mors-es/maison-petales/docs/README.md

# Maison en Pétales

Bienvenue sur le répertoire de la documentation de la Maison en Pétales.

Vous trouverez les notices sous format PDF dans le dossier `notices`.

Les plans se trouvent dans le dossier `plans`.

Enfin le siteweb est hébergé dans le dossier `docs`.
