mors-es/maison-petales/docs/index.md

```
Tous ces documents sont en version “BETA”, toujours en phase de corrections et relectures. Nous comptons sur votre indulgence. Vous pouvez d’ailleurs faire remonter vos remarques/corrections à l’adresse suivante: doc@mors.es

C’est l’occasion de signaler, que ce soit sous forme de “Maison Nomade” ou de “Maison en Pétales”, il existe moins de 4 modèles réalisés. Aucun d'entre eux n’a fait l'objet d’une étude de structure, mais aujourd’hui tous ces modèles sont encore debout après plus de 10 ans pour le premier modèle et plus de 6 montages/démontages. La structure devrait pouvoir tenir une large gamme de conditions, mais à défaut d’une étude propre au projet, les personnes dernières la conception et la documentation se déchargent de toutes responsabilités sur les différentes mises en œuvre.

Nous sommes d’ailleurs à la recherche d’étudiants, d’un bureau ou d’ingénieurs indépendants prêts à nous aider dans la réalisation d’une étude de structure.
```

**Recevez les dernières mise à jour de la documentation**

<div id="mc_embed_shell">
<div id="mc_embed_signup">
    <form action="https://maisonpetales.us10.list-manage.com/subscribe/post?id=a24535dec3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" method="post" id="mc-embedded-subscribe-form" name="mc-embedded-subscribe-form" class="validate" target="_self" novalidate="">
        <div id="mc_embed_signup_scroll">
        <div class="mc-field-group"><input placeholder="email" type="email" name="EMAIL" class="required email" id="mce-EMAIL" required="" value=""></div>
        <div hidden=""><input type="hidden" name="tags" value="14261816"></div>
        <div id="mce-responses" class="clear foot">

        </div>
        <div style="position: absolute; left: -5000px;" aria-hidden="true">
        <input type="text" name="b_5c34adf9c85700841f7de761f_a24535dec3" tabindex="-1" value="">
    </div>
        <div class="optionalParent">
            <div class="clear foot">
                <input type="submit" name="subscribe" id="mc-embedded-subscribe" class="button" value="S'inscrire">
            </div>
        </div>
    </div>
</form>
</div>
</div>

*En cliquant sur "S'inscrire" vous vous inscrivez à la liste de diffusion à propos de la documentation de la Maison en Pétales (maximum 6 e-mails/an)*

## Sommaire

La documentation de la Maison en Pétales se compose de **15 notices sous format A5**. A commencer par une notice d'**introduction**.

* 0 - La Maison en Pétales (*A venir*)

On a ensuite les notices **PIÈCES** qui parlent de la réalisation des différentes “pièces” à assembler de la Maison en Pétales.

* [A - Plancher](https://github.com/mors-es/maison-petales/blob/main/notices/a_plancher.pdf?raw=true) ([format à imprimer](https://github.com/mors-es/maison-petales/blob/main/notices/a_plancher_print.pdf?raw=true))
* [B - Piliers](https://github.com/mors-es/maison-petales/blob/main/notices/b_piliers.pdf?raw=true)  ([format à imprimer](https://github.com/mors-es/maison-petales/blob/main/notices/b_piliers_print.pdf?raw=true))
* [C - Cadres](https://github.com/mors-es/maison-petales/blob/main/notices/c_cadres.pdf?raw=true)  ([format à imprimer](https://github.com/mors-es/maison-petales/blob/main/notices/c_cadres_print.pdf?raw=true))
* [D - Toiture](https://github.com/mors-es/maison-petales/blob/main/notices/d_toiture.pdf?raw=true)  ([format à imprimer](https://github.com/mors-es/maison-petales/blob/main/notices/d_toiture_print.pdf?raw=true))
* E - Marbres (*A venir*)

Les notices **ÉDIFICATION** parlent de la construction de la Maison en Pétales à partir des pièces préfabriquées et des consommables (pare-pluie, isolants, etc.).

* [1 - Fondations](https://github.com/mors-es/maison-petales/blob/main/notices/1_fondations.pdf?raw=true) ([format à imprimer](https://github.com/mors-es/maison-petales/blob/main/notices/1_fondations_print.pdf?raw=true))
* [2 - Plancher](https://github.com/mors-es/maison-petales/blob/main/notices/2_plancher.pdf?raw=true) ([format à imprimer](https://github.com/mors-es/maison-petales/blob/main/notices/2_plancher_print.pdf?raw=true))
* [3 - Structure](https://github.com/mors-es/maison-petales/blob/main/notices/3_structure.pdf?raw=true) ([format à imprimer](https://github.com/mors-es/maison-petales/blob/main/notices/3_structure_print.pdf?raw=true))
* [4 - Ossatures et menuiseries](https://github.com/mors-es/maison-petales/blob/main/notices/4_ossatures_menuiseries.pdf?raw=true) ([format à imprimer](https://github.com/mors-es/maison-petales/blob/main/notices/4_ossatures_menuiseries_print.pdf?raw=true))
* [5 - Isolation et étanchéité](https://github.com/mors-es/maison-petales/blob/main/notices/5_isolation_etancheite.pdf?raw=true) ([format à imprimer](https://github.com/mors-es/maison-petales/blob/main/notices/5_isolation_etancheite_print.pdf?raw=true))
* 6 - Couverture (*A venir*)

> Les notices PIÈCES et ÉDIFICATIONS seront sous format Foldy Zine, une partie *livret* avec textes et illustrations pouvant être lue à son aise et une partie intérieure avec des *planches de dessins* (*A venir*) résumant les étapes à suivre à l’atelier ou sur le chantier. Actuellement seule la partie livret A5 est en cours de réalisation.

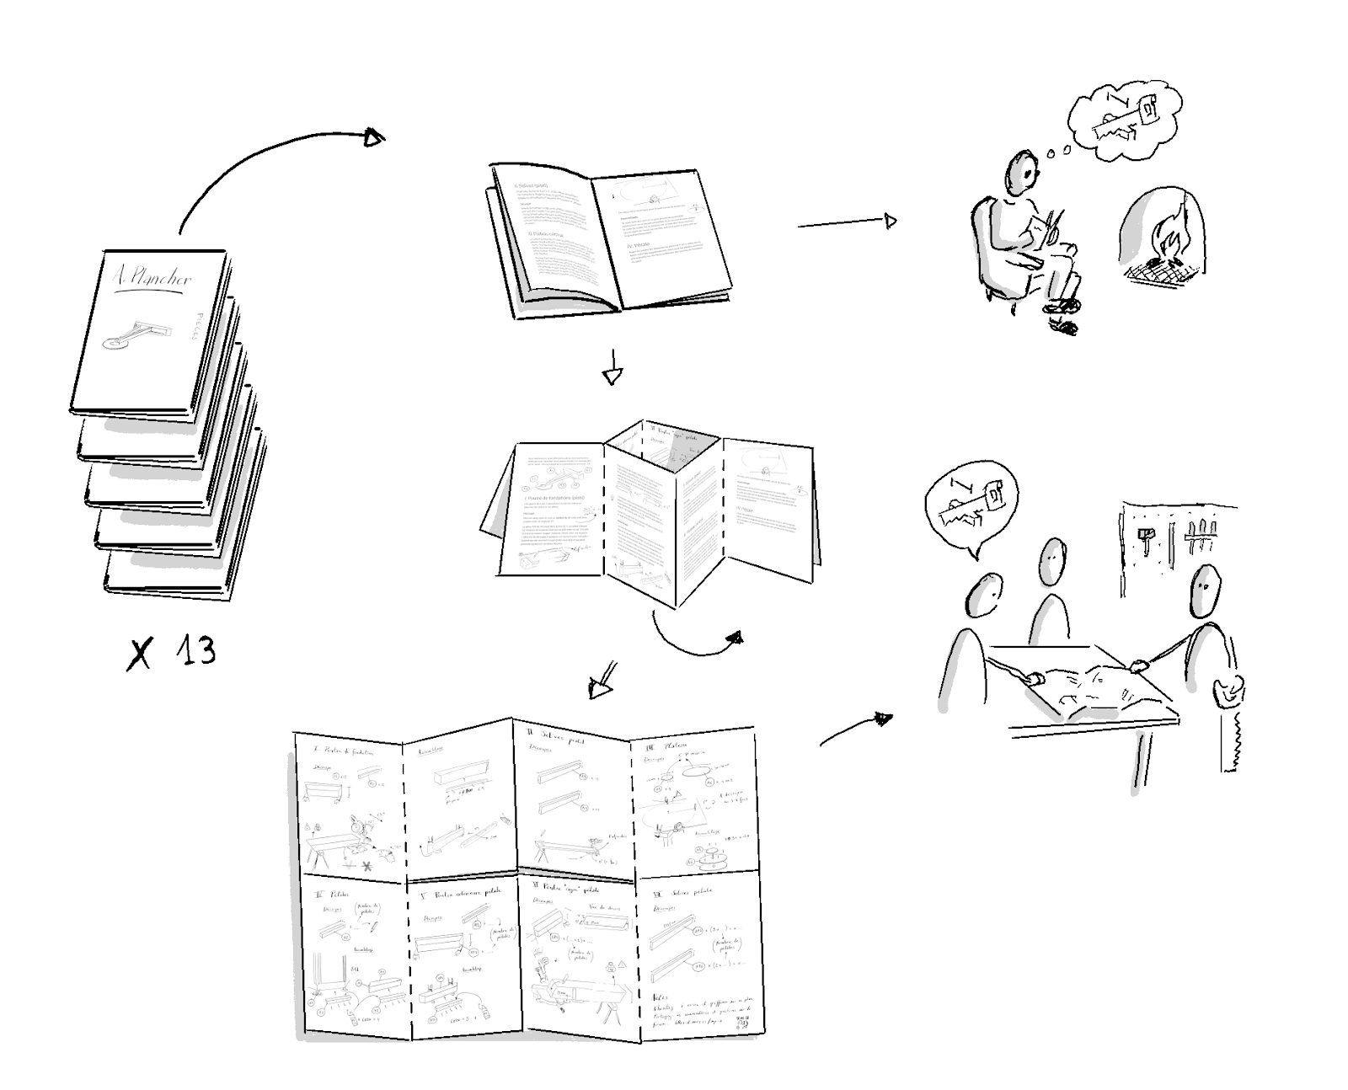
[picture p57: docs/assets/img/foldy_zine.png]


Enfin, les notices **ORGANISATION** sont des livrets plus transversaux permettant d’avoir la vue d’ensemble sur la construction de la Maison en Pétales

* X - Chantier (lieu, outils nécessaires, calendrier, etc.) (*A venir*)
* [Y - Plans & Débits](https://github.com/mors-es/maison-petales/blob/main/notices/y_plans_debits.pdf?raw=true) (plans et vues de coupes de toutes les pièces, listes des débits, consommables). (*Non terminé*, [Tableau des débit](https://docs.google.com/spreadsheets/d/192lDf3B4wyAeSEpOTd4wxV1w-MeTvV6zNtPiaQi830A/edit?usp=sharing), *Non terminé*)

> Cette notice n’en est pas vraiment une car elle prend la forme d’un grand plan en format A0 à afficher dans l’atelier pour y trouver l’ensemble des mesures et débits. Ce plan peut aussi être utilisé pour marquer la progression de ce qui a déjà été fait.

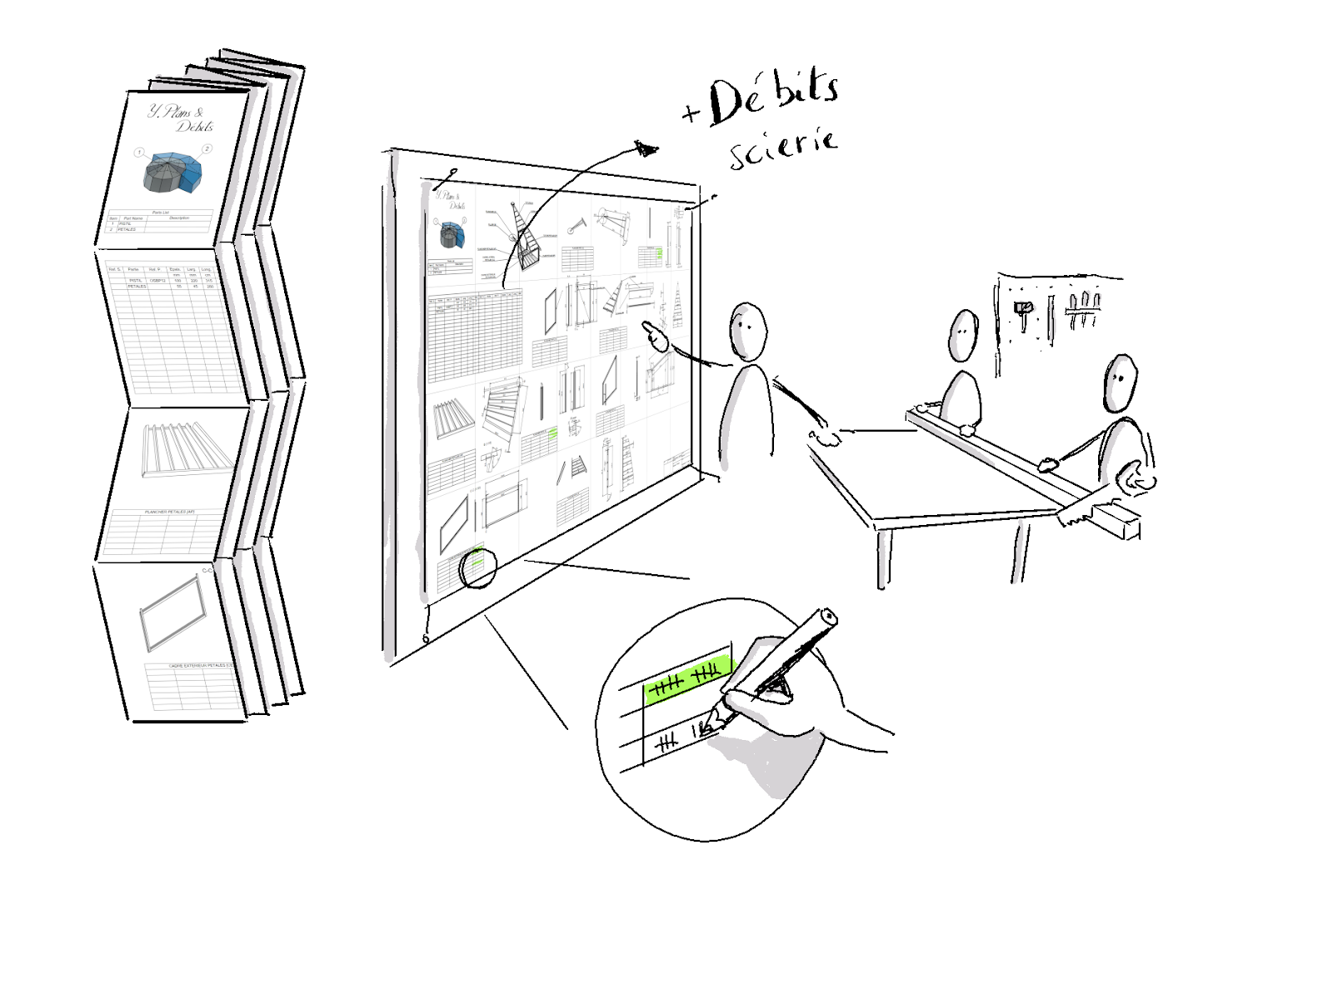
[picture p58: docs/assets/img/plan_atelier.png]


* Z - Conseils, Trucs et Astuces (utilisation des outils, conseils, vocabulaires, FAQ, etc.)  (*A venir*)

## Autres liens

* [Maisons Nomades/Maison en Pétales](https://www.maisonsnomades.net/la-maison-en-p%C3%A9tales): Le siteweb du concepteur de l'habitat, Yves Desarzens. Vous y trouverez la genèse du projet, ainsi que les plans 3D Sketch Up.
* [Le Croissant Fertile](https://lecroissant.desobeissancefertile.com/): Lieu d'expérimentation autour de l'habitat réversible dans le Perigord Vert, là où la premère Maison en Pétales a été réalisée.
* [Et Saar'part](https://www.youtube.com/@EtSaarpart): Chaine du Youtubeur *Saar* qui a tourné 8 vidéos tutorielles sur l'édification de la première Maison en Pétales. 

## Contribuer

Comme vous pouvez le voir cette documentation n'est pas encore terminée. Il existe plusieurs manières d'amener sa pierre à l'édifice.

### Remarques et relecture

Toutes remarques/retours sur la documentation sont les bienvenues, la mise en place d'un forum de discussion est envisagé. En attendant vous pouvez envoyer vos remarques à l'adresse suivante: doc@mors.es

D'ores et déjà un tout grand merci à Aurélie, Benoit, Louise et Yves pour la relecture et vos conseils avisés. Plus largement, merci à tous les participants et participantes du chantier de la Maison en Pétales de septembre 2023 au Croissant Fertile sans qui cette documentation n'aurait été possible.

### Financièrement

Vous pouvez également décider de soutenir le projet en participant financièrement aux frais qu'il occasionne. Sur [Liberapay](https://fr.liberapay.com/Morses/donate) ou [mon PayPal](http://paypal.me/dmorses) (Dorian aka Morses). Il est également possible de [soutenir la dynamique du Croissant Fertile](https://lecroissant.desobeissancefertile.com/nous-soutenir/) ou encore [les projets vidéos de Saar](https://etsaarpart.odoo.com/shop/donesp-soutiens-notre-travail-fais-une-donation-a-et-saar-part-6#attr=).

### Recherche et développement

Le projet vous inspire, vous avez des connaissances dans le domaine de l'éco-construction. Nous aider dans une étude de structure, d'impact ou tous nouveaux développements peuvent permettre à ce chouette projet de grandir.
