mors-es/maison-petales/(list of files, cad)

Other CAD files:
plans/Mn 40m² avancement Août 2023.skp
