mors-es/maison-petales/notices/4_ossatures_menuiseries_print.pdf

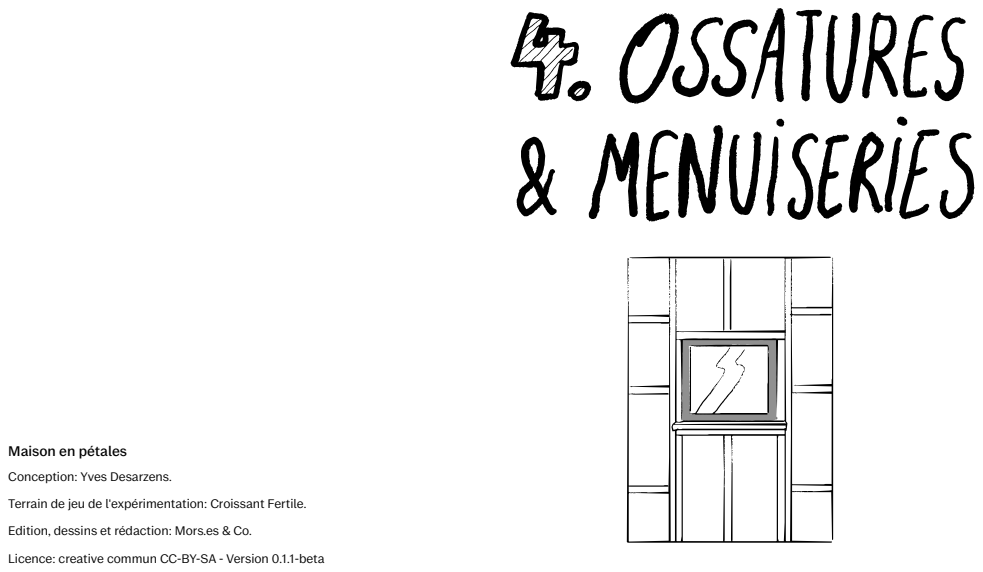
[picture p90: page 1]

Maison en pétales

Conception: Yves Desarzens.

Terrain de jeu de l'expérimentation: Croissant Fertile.

Edition, dessins et rédaction: Mors.es & Co.

Licence: creative commun CC-BY-SA - Version 0.1.1-beta

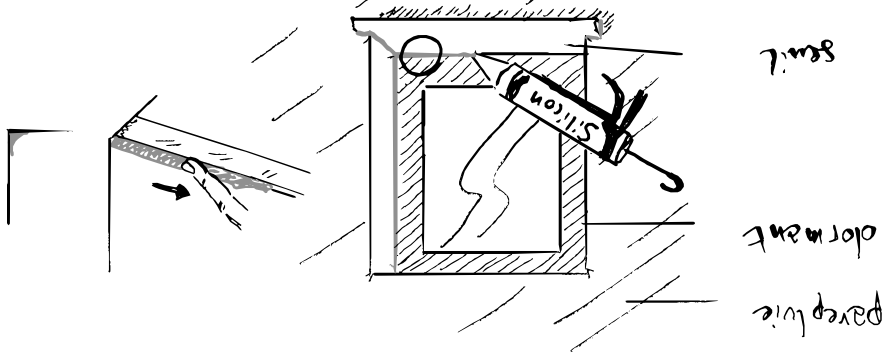
[picture p91: figure]

Etanchéité extérieure

Les menuiseries sont des points sensibles en termes mieux est de d'infiltration d'eau. Pour rendre le tout étanche, le

, parapluie et seuil. Pour dormant poser un joint de silicone entre peinture et de faire un joint propre on peut s'aider de scotch de oncave. son doigt mouillé à l’eau savonneuse pour le rendre c a juste pas de Pour les portes, c'est similaire aux fenêtres, il n'y

traverses basses.

choisis, Il existe plusieurs mises en œuvre selon les éléments r en savoir n’hésitez pas à lire les manuels des fournisseurs pou

plus.

de la Maintenant que nous avons notre structure, il s'agit

) 5 - Isolation & Étanchéité remplir. Cette notice et la suivante ( re sont intrinsèquement liées. On va traiter ça de maniè nes thématique en commençant par l'ossature. Mais certai tâches doivent être attaquées en parallèle.

ne Les cadres par défaut sont composés à l'intérieur d'u héité à l'air couverture en plaques d'OSB (12mm) qui fait l'étanc s cadres et le contreventement des cadres. Mais la surface de tement. Il est bien trop grande pour pouvoir poser l'OSB direc ifier et faut des montants en bois intermédiaires pour rigid permettre de visser les planches d'OSB sur le mur.

de bois de On va travailler ici exclusivement avec des pièces

40x105 mm non rabotées (car non visibles).

56 cm car nos On a fait le choix de mettre les montants tous les arge, il panneaux d’isolant en laine de bois font 57,5 cm de l apter selon suffit alors de les rentrer en force (Écartement à ad e la pose des les dimensions de l’isolant choisi). Dans le cadre d harge des montants d’ossature il faut penser à la reprise de c arbalétriers intermédiaires des pétales

Il existe plusieurs types de menuiseries. Ci-dessus le cas d’une menuiserie ALU. N’hésitez pas à lire la littérature.

On retire d'abord l'ouvrant, ensuite on applique une
compribande dans la réservation prévue à cet effet tout autour de la fenêtre. Elle est alors placée dans l'encadrure. Dans notre cas, la fenêtre vient à ras de la surface du mur. L’OSB n’étant pas encore posé (voir Notice 5), on peut s’aider d’une chute de 12 mm pour positionner la fenêtre.

Enfin de fines cales sont utilisées pour bien positionner la fenêtre. Vérifier l'équerrage en comparant les diagonales qui doivent être égales. Puis elle est fixée définitivement avec 4 à 6 vis de 60 mm selon indication du constructeur. L’ouvrant peut aussi être repositionné pour voir s'il s'ouvre et se ferme toujours correctement.

On va donc couper des montants de la hauteur de l'intérieur des cadres (par exemple XX cm pour les cadres des pistils). Pour les cadres latéraux, il faudra couper le sommet avec un angle de 20°.

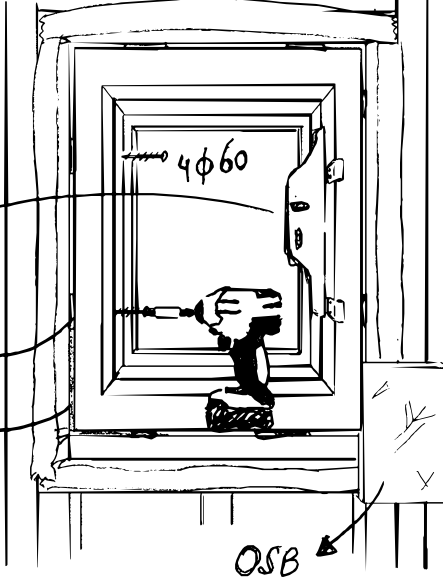
[picture p92: figure]

Il est fort probable que le dernier entraxe n’égale pas la largeur de l’isolant, il faudra donc le découper (voir notice 5 Isolation & Etanchéité). Pour éviter le flambement des montants verticaux il peut être nécessaire d’ajouter des entretoises de 56 cm entre les montants pour rigidifier le tout. De manière similaire il faut les fixer à des hauteurs multiples de l’isolant moins 1 ou 2 cm. Dans notre exemple 120 cm (car isolant de 122 cm de long).

l'aide L'ensemble des montants sont alors cloués ensemble à de d'une cloueuse (3-4 clous de 60 mm par fixation cloués averses manière oblique). Il est important que montants et tr er les soient positionnés à niveau. Il peut être bon de vérifi doubler la mesures également (haut et bas). Il est conseillé de traverse haute pour augmenter sa rigidité.

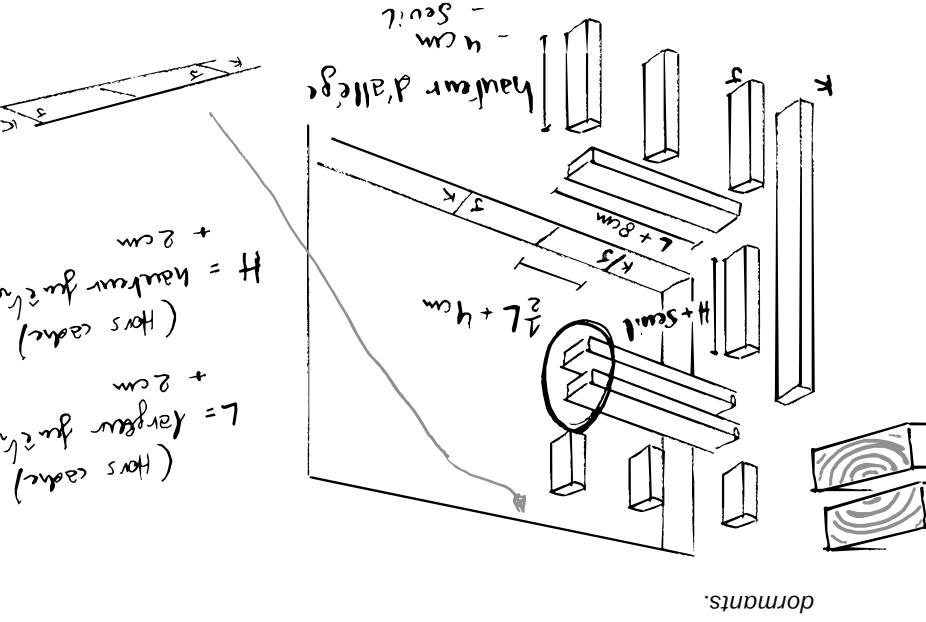
[picture p93: figure]
. dormants

le, il est Lorsque des montants ou traverses sont cloués ensemb r éviter de bon usage de les positionner "coeur à coeur" pou d'éventuelles déformations.

ns des Les seuils des menuiseries peuvent être façonnés da e seuil chutes de bois d'au moins 15 cm de large pour que l une pente de puisse déborder du bardage. Il faut que le seuil aie électrique. 3% ou plus, qui sera réalisée avec un rabot à main ou peut être fait à la scie plongeante. larmier Un are-pluie qui Avant de poser le seuil, il faut venir découper le p rabattre le aura été posé entre temps (voir Notice 5). On vient es montants et pare-pluie vers l'intérieur et le scotcher le long d arapluie où des traverses. Enfin le seuil est posé au-dessus du p r faire du mastic-colle PU sera préalablement appliquée pou

l'étanchéité.

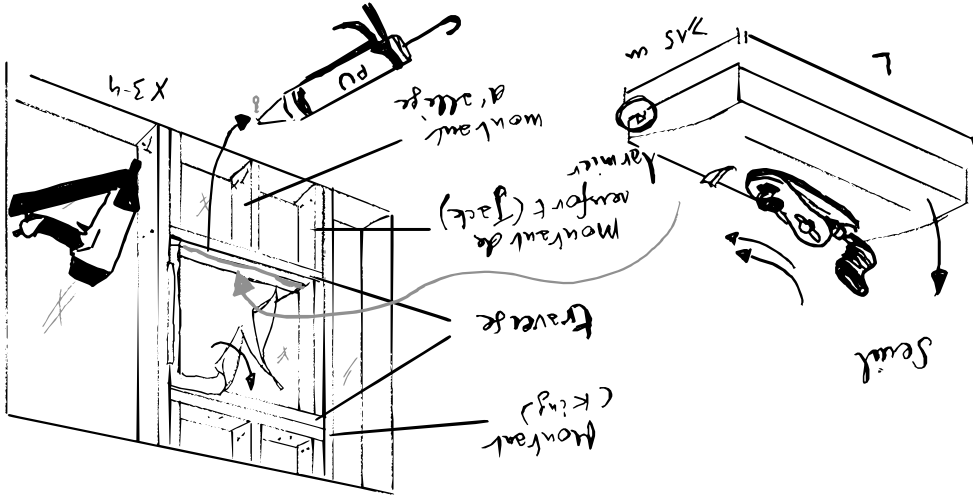
[picture p94: figure]

ique un peu. Si on a une fenêtre ou une porte, alors ça se compl onnes dont Il ne faut pas hésiter à se faire aider par des pers

c'est le métier.

, il y a plusieurs mesures pose en Tunnel Dans le cas d’une hors teur importantes: Les deux premières sont la largeur et hau

). Pour les H et L de la fenêtre plus 1 à 2 cm de marge ( cadre

) et les traverses, Jack ), les montants de renfort ( King montants ( cm (SX) on va utiliser le bois raboté 4 faces en 4 cm par 10,5 ser le non- pour les allèges ou le reste du cadre on peut utili

raboté (SY).

du cadre où On vient marquer le centre de la fenêtre dans le bas à la droite et la elle sera positionnée (pistil ou pétale) et ensuite

+ 4 cm. On vient L gauche de ce centre on marque un demi allège d’ ensuite couper les montants de renfort à la hauteur

On coupe moins 4 cm (traverse) et moins la hauteur du seuil.

es également les traverses et les montants encadrant l
