mors-es/maison-petales/notices/5_isolation_etancheite_print.pdf

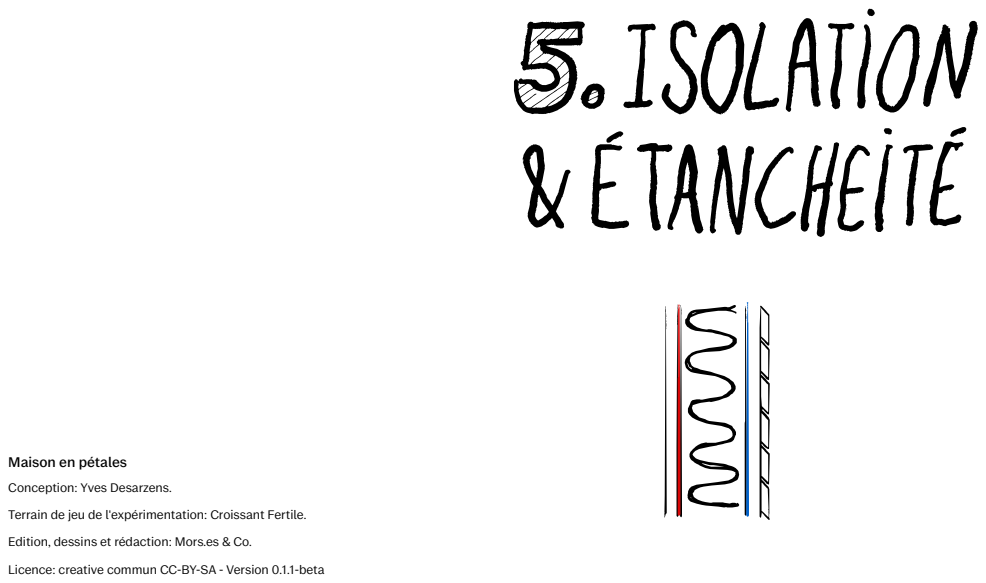
[picture p95: page 1]

Maison en pétales

Conception: Yves Desarzens.

Terrain de jeu de l'expérimentation: Croissant Fertile.

Edition, dessins et rédaction: Mors.es & Co.

Licence: creative commun CC-BY-SA - Version 0.1.1-beta

poser Juste avant de poser les OSB des murs internes, on va e (C4 et des bandes de 30 cm de frein-vapeur d'un bord de cadr deux. On vient C6) au cadre suivant recouvrant le pilier entre les frein-vapeur appliquer une fine bande de colle PU sur le bord du iseries et la pour l'étanchéité ainsi que sur le contour des menu

lisse basse.

SB, quitte à A ras de cette dernière on vient poser le premier O eut être s'aider de petits cales de ~5 mm. Ensuite la chute p

8 par utilisée au-dessus. On utilise des vis de 40 mm, 4 à

planche.

qui supporte la Pour isoler le plancher il faut utiliser un isolant s comprimée compression. Ici nous utiliserons de la laine de boi oser un OSB de 6 cm d'épais et qui s'emboite. Ensuite on vient p reuve d'un de 18 mm en "sur-plancher" flottant. Il faudra faire p angles. peu de patience pour les découpes, notamment dans les

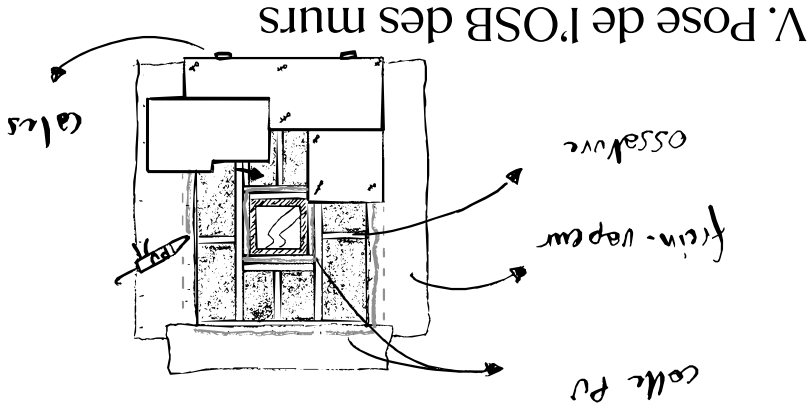
[picture p96: figure]

struction Par rapport à d'autres méthodes constructives, la con olation et en bois demande beaucoup d'attention en termes d'is notamment de gestion des flux d’air. En effet la structure est tériorer sensible à l'humidité qui sur le long terme peut dé l’ossature bois et l’isolant de la maison.

Principe de base

imite les flux Dans la construction ossature bois le frein-vapeur l vitant le d’air et la pénétration d'humidité dans les parois, é rriture de risque de condensation dans les murs et donc de pou aire sortir l’air l’isolant ou de la structure. L’idée de base est de f

(sorties par les contrôlées humide intérieur par des sorties p de fenêtres, bouches d’aération ou VMC). Il existe beaucou

: on veut éviter à tout A retenir littérature pour creuser le sujet.

prix que l'air humide intérieur migre dans la paroi.

une simple Le schéma suivant semble complexe, mais il s'agit d' tance de la coupe verticale au niveau du pistil. On voit l'impor

. La ligne bleue continuité à l'intérieur du frein-vapeur (en rouge) il est perspirant représente le pare-pluie. Ce dernier étant midité des nécessaire de prévoir une lame d'air pour évacuer l'hu

murs.

nc une Le pare-pluie supporte mal les UVs du soleil, on a do n bardage couverture finale (voir Notice 6), ici dans l'exemple u bois sur les murs et de l'EPDM en toiture.

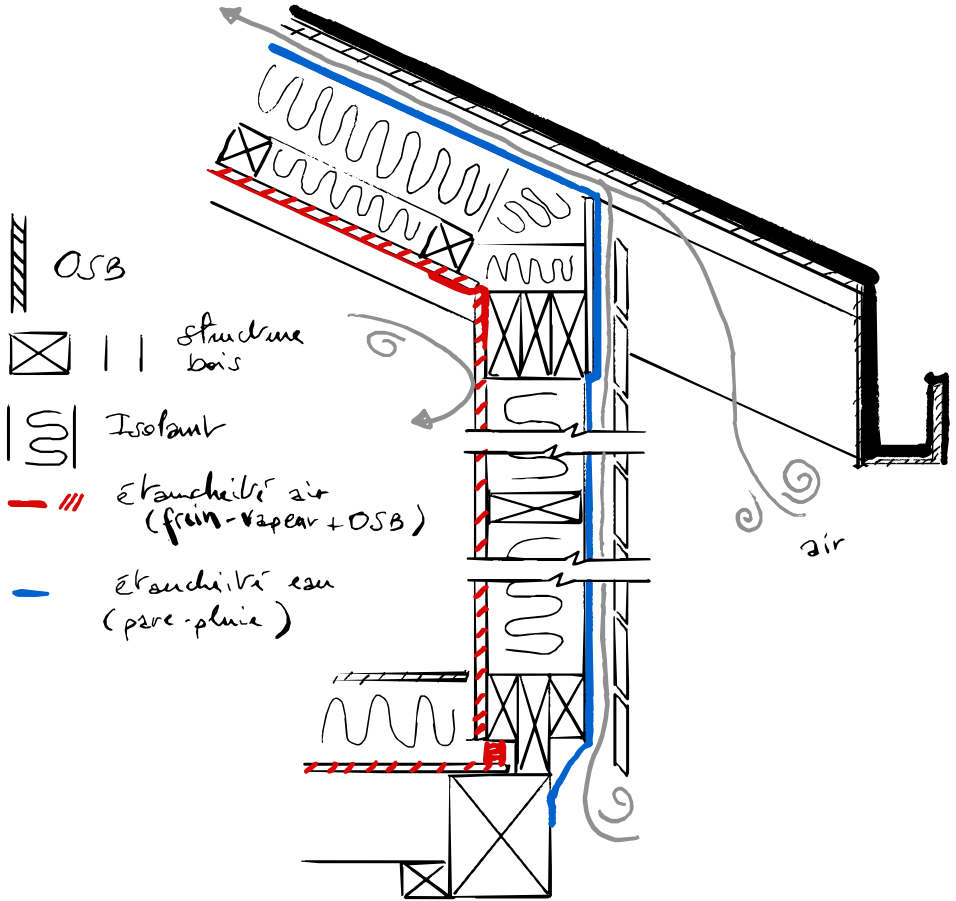
[picture p97: figure]

Le parapluie vient se poser en commençant par le bas en laissant au minimum 30 cm de débord à l’extérieur des cadres. Sur la toiture, il est plié pour passer d'un pan de toit à l’autre. Le niveau suivant vient se poser par-dessus en chevauchant le précédent d'au moins 20 cm. Il faut suivre le chemin que font les gouttes d'eau pour qu'elle ne passe jamais sous un pare pluie. Il est ensuite agrafé sur les arbalétriers. Enfin on scotch les lés avec de l’adhésif pour pare-pluie.

Pour les murs on va "emballer" la structure. en commençant par le bas avec assez de longueur pour fixer le bas du pare-pluie sur les poutres de fondation. On viendra perçer les trous des menuiseries pour venir les y placer ensuite (voir Notice 4).

Lorsque l'ossature des murs est faite (voir Notice 4), on peut venir placer les panneaux d'isolant (10 cm) entre les montants. Attention à bien remplir, notamment les trous et fentes (par exemple entre les cadres et piliers). Pour cela, on peut prendre de l'isolant en vrac et le rentrer en force avec un tournevis ou un ciseau à bois. Une bande d'1mm longue de 10 mètres équivaut à un carré ouvert de 10 cm x 10 cm.

Il est conseillé de s'attaquer d'abord au toit pour mettre la structure à l'abri des intempéries.

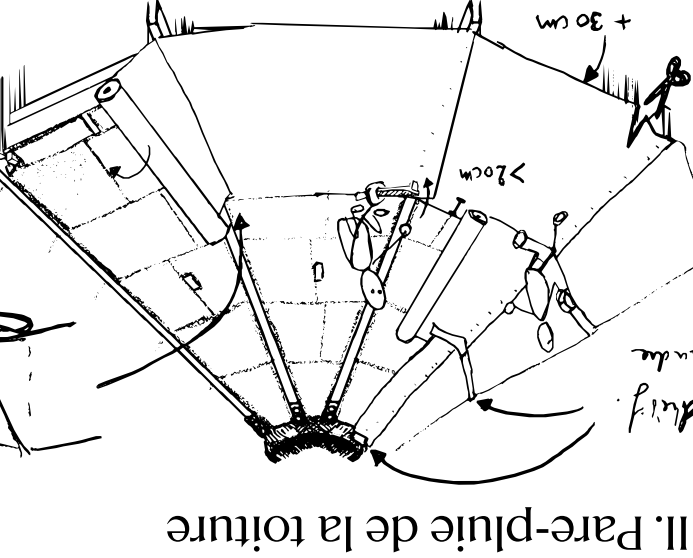
[picture p98: figure]

ère de 6 Ensuite deux couches d'isolant sont posées. Une premi onde de cm d'épaisseur entre les empanons et ensuite une sec à mesure 10 cm par-dessus tout. Les coupes se font au fur et

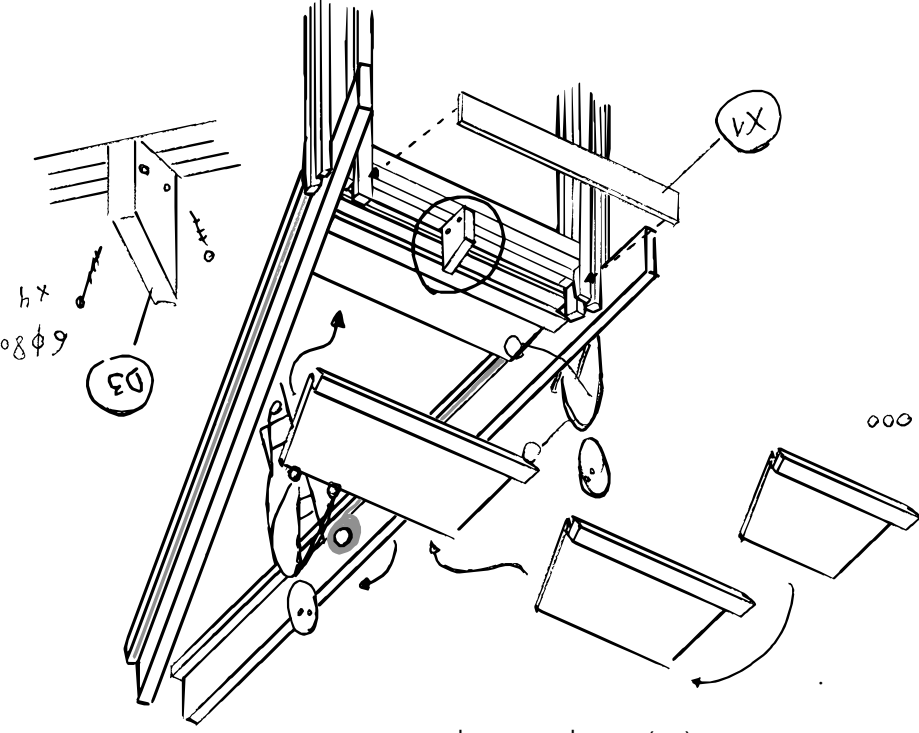
[picture p99: figure]

ond peuvent pour éviter les chutes. Des chutes de l'OSB du plaf ussi fixer la aider à faire la coupe d'angle de l’isolant. Il faut a reprise (D6) sur le 4ème empanon.

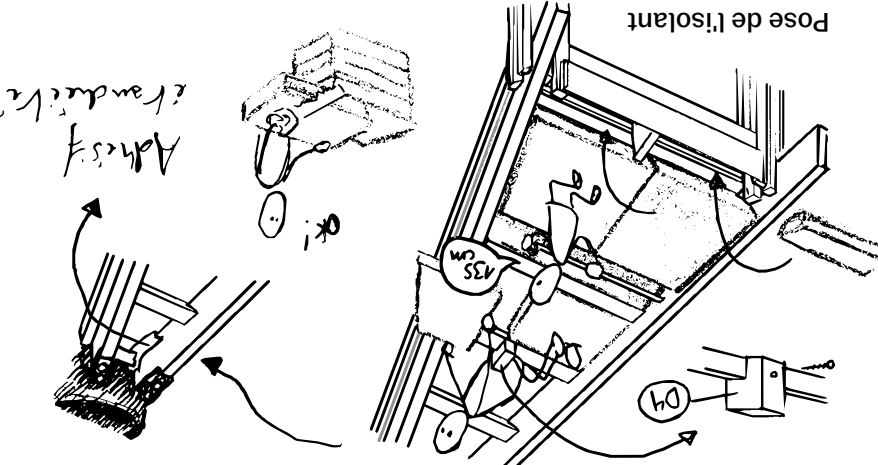
[picture p100: figure]
Pose de l'isolant

Pose de l'OSB servant de plafond

, une série d'OSB ont été coupés et D - toiture Dans la notice nd de la assemblés avec des empanons. Ces OSB seront le plafo l'étanchéité maison en pétales. Ils supportent l'isolation et font

à l'air de la toiture.

Avant d'emboiter les OSB ensemble, on va poser un

DP2 et DP4) compribande sur les fourrures des arbalétriers (D2, pour garantir l'étanchéité à l'air.

En commençant par le bas, les modules du plafond sont fixer, sur encastrés les uns dans les autres. C'est l'occasion de reprise de la les cadres du pistil qui n'auront pas de pétale, la la toiture. contre latte (D3) ainsi que l'OSB qui vient "fermer"
