mors-es/maison-petales/notices/a_plancher_print.pdf

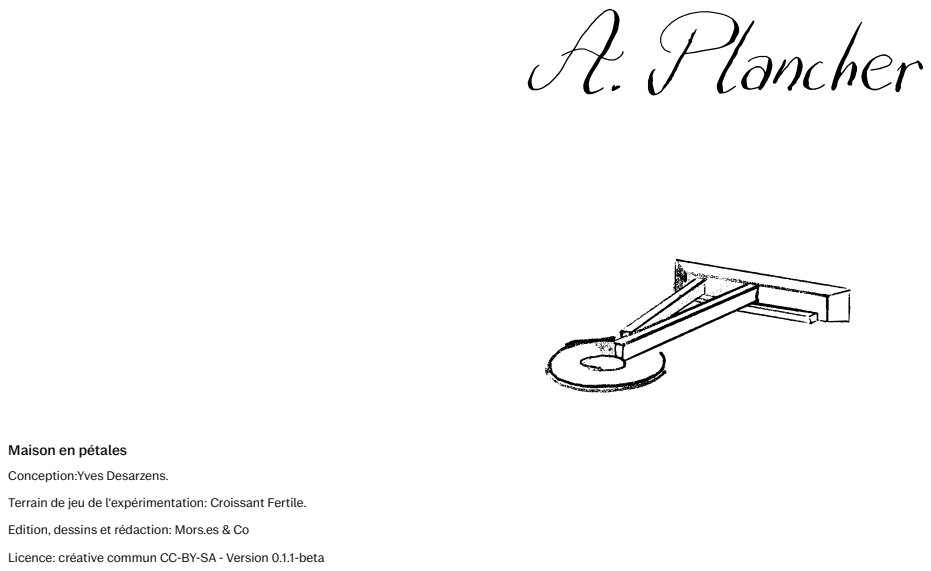
[picture p101: page 1]

Maison en pétales

Conception:Yves Desarzens.

Terrain de jeu de l'expérimentation: Croissant Fertile.

Edition, dessins et rédaction: Mors.es & Co

Licence: créative commun CC-BY-SA - Version 0.1.1-beta

e coupe Rien de sorcier ici, on se retrouve avec 2 longueurs d différentes (299 et 303 cm).

hésiter à écrire (ces notices sont faites pour vivre il ne faut pas qui dans les marges toutes informations complémentaires

semblent utiles)

es nécessaires Est décrite ici la fabrication des différentes pièc es. En pour l'édification du plancher de la Maison en Pétal

. Voici les différentes pièces, voir notice Pistil commençant par le

. Y - Plans et Débits

s Ces poutres de 10 cm par 22 cm reprennent la charge de solives, du plancher, des cadres et des piliers.

Découpes

. Elles sont nombre de 12 Les poutres ont deux côtés et sont au r du donc coupées avec un angle de 15° pour faire le tou plancher qui est inscrit dans un cercle.

end d'abord La pièce (A1) est découpée dans le brut (S-12). On pr rab'. Ensuite les mesures de la pièce pour voir ce qu'il reste en équerre. on trace la mesure "longue" (externe, 193 cm) avec une

"rafraîchir" L'idéal est de découper à quelques cm du bord pour en scierie et qui peut droite la pièce qui est rarement coupée présenter également certaines fissures.

Pour les "pétales" il y a deux types de poutres de fondation. Les rayons qui "prolongent" le pistil et les extérieures. Les poutres dites extérieures (AP1) seront coupées et assemblées de la même manière que les poutres du pistil avec leur solivette (AP2).

Les poutres “rayons” (AP3) sont plus particulières. En effet la forme de ces dernières n'est pas trapézoïdale mais est sous la forme d'un parallélépipède avec une légère coupe de biseau.

Pour la découpe de l'angle, l'idéal est d'avoir accès à une scie à onglet radiale à grand disque (> 300 mm). On règle l'angle d'inclinaison de la lame à 15° et on coupe la poutre en 3-4 passages pour éviter de trop user le moteur. Attention à être bien à plat sur le plateau de la scie et avoir une bonne servante vu le poids de la poutre.

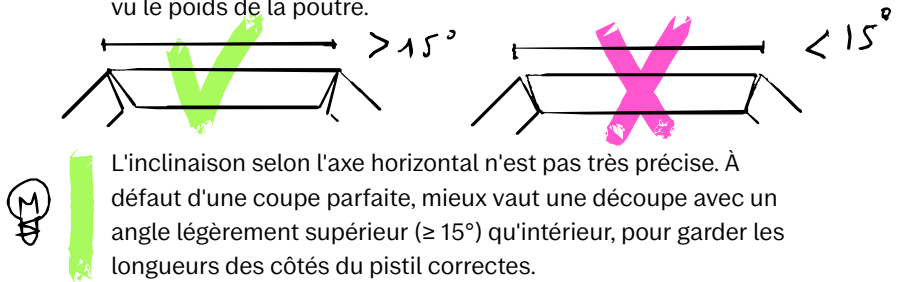
[picture p102: figure]

L'inclinaison selon l'axe horizontal n'est pas très précise. À défaut d'une coupe parfaite, mieux vaut une découpe avec un angle légèrement supérieur (≥ 15°) qu'intérieur, pour garder les longueurs des côtés du pistil correctes.

Ensuite, il faut découper les solivettes (A2) dans le bois (S-11) en angle droit d'une longueur de 160 cm.

Assemblage

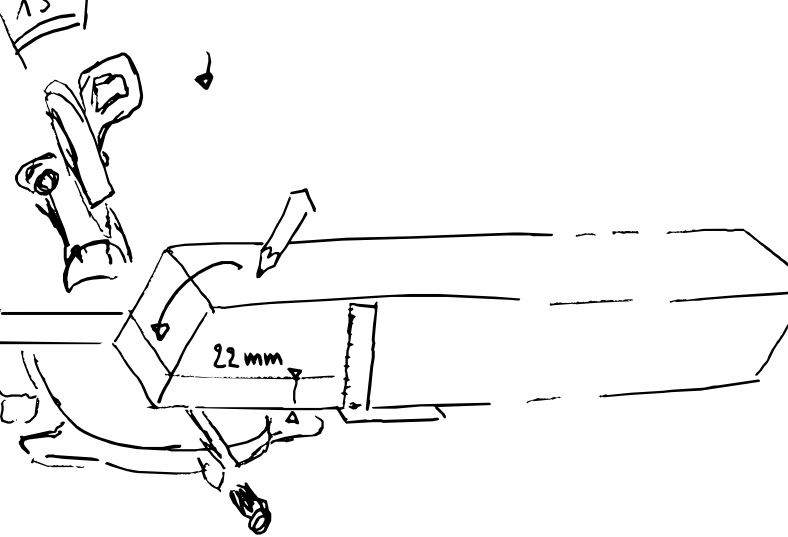
[picture p103: figure]

Les solivettes sont vissées-collées sur les poutres de fondations avec de la colle PU et 4 vis (6⌀100). On pré-perce les 4 trous pour les vis dans la solivette (entre 4-6 mm de diamètre), on vient poser ensuite la colle sur la face de la solivette qui sera collée. Les solivettes sont visées avec une visseuse dans le bas de la face intérieur au pistil de la poutre de fondations. Des cales peuvent aider à placer plus facilement la solivette.

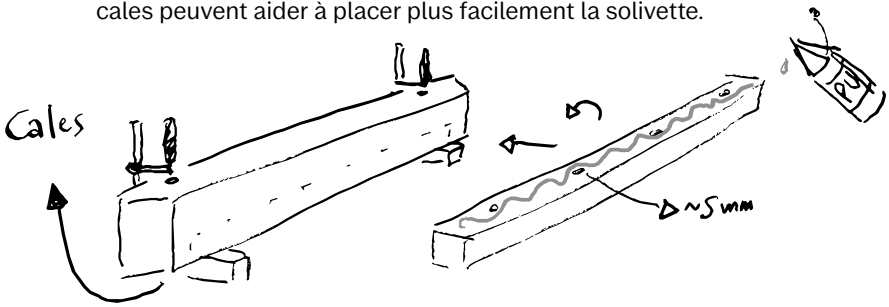
[picture p104: figure]

e butée (A6). On réitérera cette technique pour le petit cercle d

Assemblage

bler Si vous avez deux cercles (A5) vous pouvez les assem ite simplement en les vissant ensemble. Vous pouvez ensu

(A6) bien au centre du plateau (A5) soit cercle de butée visser le les cercles, soit à l'aide des trous centraux qui on servit à tracer t. en traçant le petit cercle sur le grand préalablemen olives des Avant de produire les poutres de fondation et les s res (A2) pétales, il faut découper des solivettes supplémentai les faces pour les pétales. Ces solivettes sont assemblées sur vont accueillir extérieures des poutres de fondation du pistil qui

les pétales.

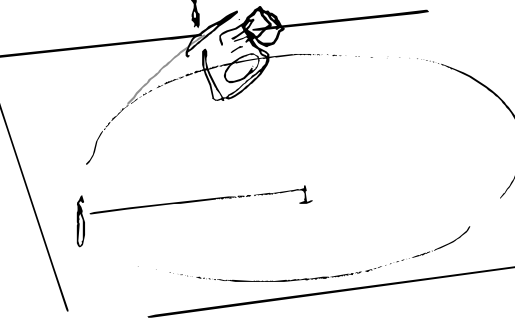
[picture p105: figure]

lives du Coupées dans du bois de 4,5 cm par 16 cm (S-8), les so her, les plancher vont reprendre la charge du poids du planc s. meubles et les êtres vivants de la Maison en Pétale

Découpes

à 90° à faire à Rien de plus simple. Il s'agit ici de simples coupes cm (A3) qui la scie à onglet. Il y a douze solives longues de 333 vingt- seront perpendiculaires aux poutres de fondation et ndront se quatre solives, plus courtes, de 328,5 cm (A4) qui vie voir notice placer proche des angles des poutres de fondation,

. Y Plans & Débits

posées sur un Les solives partant des 12 côtés du pistil vont être

. Ce plateau central rond avec un diamètre de 130 cm (A5)

Son dernier est idéalement en contre-plaqué (CP) marine.

épaisseur sera plus grande que 20 mm. On peut aussi superposer deux CP de 10-15mm par exemple. Les solives

CP de 33,5 longues (A3) viendront en butée contre un cercle en

cm de diamètre (A6).

Découpes

thode la plus Sans être à la recherche d'un cercle parfait, la mé de d'une simple est de tracer un cercle de rayon 65 cm à l'ai teuse, on corde, d'une vis et d'un crayon. Ensuite, à la scie sau ds et suivre vient rejoindre le trait de crayon par l'un des bor udra petit à soigneusement le trait. En fonction de l'établi, il fa

. petit déplacer la planche pour ne pas couper dedans
