mors-es/maison-petales/notices/b_piliers_print.pdf

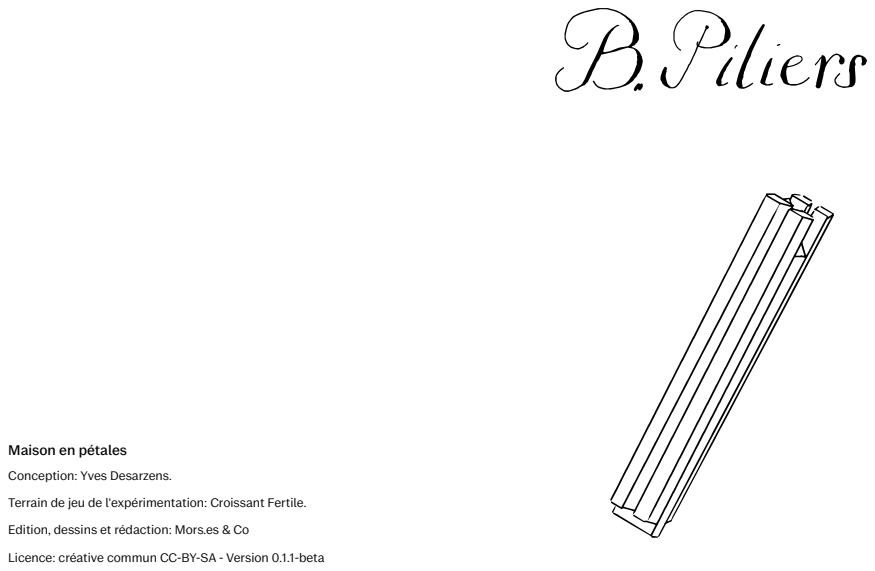
[picture p106: page 1]

Maison en pétales

Conception: Yves Desarzens.

Terrain de jeu de l'expérimentation: Croissant Fertile.

Edition, dessins et rédaction: Mors.es & Co

Licence: créative commun CC-BY-SA - Version 0.1.1-beta

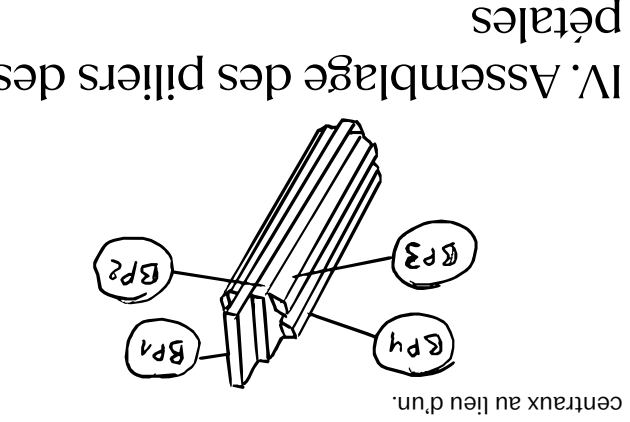
[picture p107: figure]
centraux au lieu d’un.

". Pour La colle PU étant expensive, elle risque de "déborder être éviter d'en mettre partout, la table de montage peut peut recouverte de papier sulfurisé. Et une fois sèche, on enlever l'excédent de colle avec un ciseau à bois.

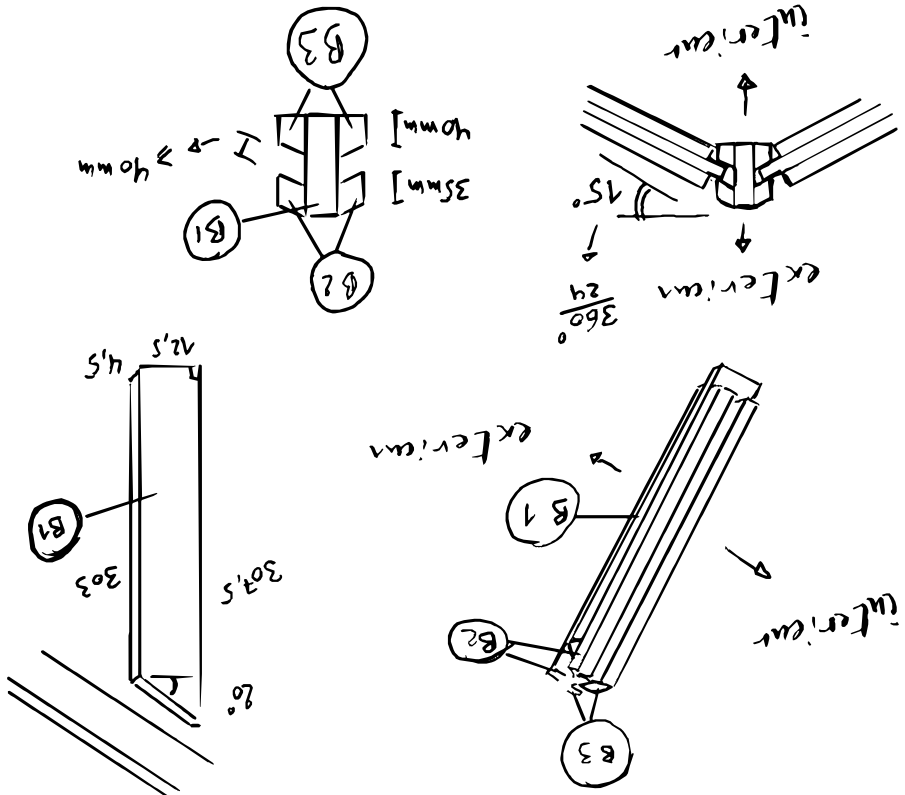
[picture p108: figure]

t reprendre Entre les pétales juxtaposés on a des piliers qui von

Y - voir notice des doubles arbalétriers et les cadres extérieurs ( s ). Relativement similaires aux piliers du pistil il Plans & Débits montants sont principalement plus courts et comportent trois implement L'assemblage est également très similaire. Il suffit s t d'y de venir coller-clouer le montant BP2 sur le BP1 avan

ajouter les fourrures.

sont les montants verticaux qui vont reprendre les piliers Les arbalétriers et les cadres.

de la Maison en Pétales compte 12 piliers. Il s'agit pistil Le fourrures 4 principalement d'un montant central (B1) entouré de

'insérer les (2x B2 et B3), créant des réservations permettant d e dessus. cadres sur les côtés ainsi que les arbalétriers sur l

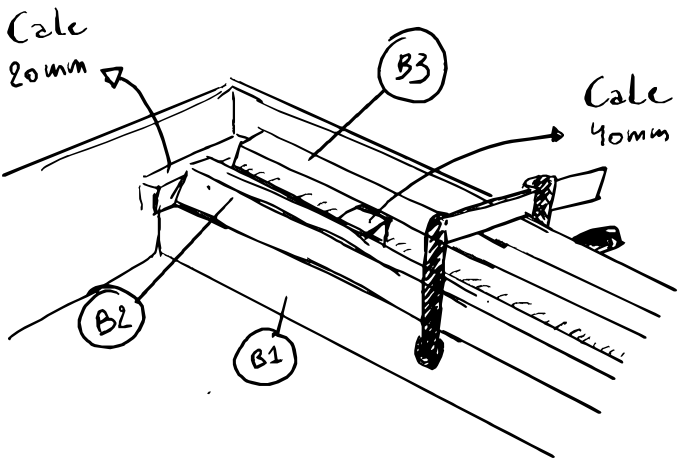
[picture p109: figure]

Pour bien positionner les éléments il faut des serre-joints ainsi que deux types de cales. Une première de 20mm pour remonter le bas des fourrures par rapport au bas du pilier et plusieurs cales de 40mm pour s'assurer qu'on aie bien un espace suffisant entre les fourrures (entre B2 et B3) quitte à ce que le montant B2 déborde légèrement.

Attention, une fois la colle PU appliquée, la prise prend une quinzaine de minutes. Pour les premiers piliers, on peut d'abord les mettre en place avant de coller pour vérifier mesures et placement.

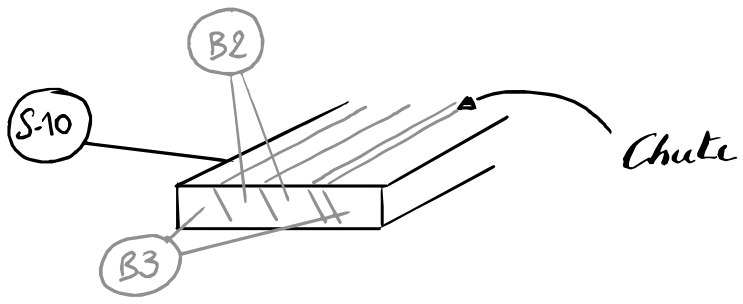
[picture p110: figure]

Une fois que les pièces sont bien positionnées, on peut mettre des clous de 63mm tous les 20 cm environ. Une personne (ou plus) peut aider à bien maintenir les montants. Lorsque c’est fait, il suffit de réaliser la même chose sur l'autre face. Il est possible que certaines pièces soient arquées ou en torsion.si c'est le cas, il vous faudra les maintenir en place lors du clouage, avec des serre-joints si nécessaire. De manière générale, vérifier lors du clouage que les pièces plaquent bien entre elles. En cas de fente de plus d'un millimètre: venir les clouer progressivement en partant d’une extrémité.

On retrouve l'angle de 15° (voir notice A - Plancher) au niveau des fourrures du pilier qui permet de donner un angle de 30° (15° de chaque côté) entre deux cadres permettant de faire au final un tour complet (360°). On peut identifier également la face plane du pilier qui sera visible de l'intérieur (avec les fourrures B3) et celle extérieure avec les fourrures B2.

Découpes des montants centraux

Un pilier comprend 3 pièces distinctes (voir notice Y - Plans & Débits). Le montant central (B1) est une pièce assez simple à réaliser, il possède une coupe en angle droit à son pied et d'une coupe à 20° à son sommet.

Découpes des fourrures

La découpe des fourrures est un peu plus délicate. Afin d'éviter trop de chutes, les 4 pièces (2×B2 et 2×B3) sont découpées dans une seule pièce de bois (S-10).

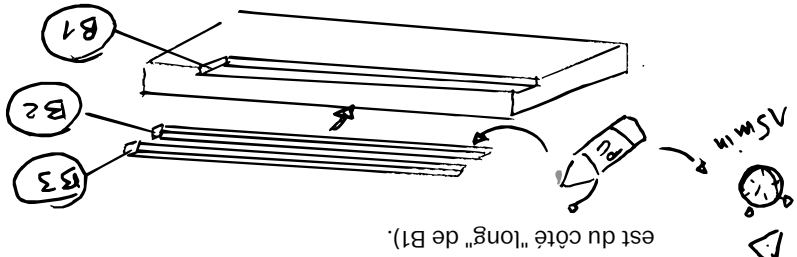
[picture p111: figure]
est du côté "long" de B1).

en chute, la partie centrale, Il reste alors une seconde le à 45 mm parallélogramme. On règle la butée de la scie sur tab fois sur la (mais on garde l’angle de 15°). On passe la chute deux une dernière table pour réaliser les deux "B2". A la fin, il reste ures cales). chute sous forme de fine latte (à garder pour de fut

B3 (24) et Pour être plus efficace, mieux vaut réaliser tous les ur table ensuite les B2 afin de ne pas devoir régler la scie s n bout de constamment. N'hésitez pas à faire un trait de scie e les bonnes planche afin de vérifier que les cotes obtenues sont

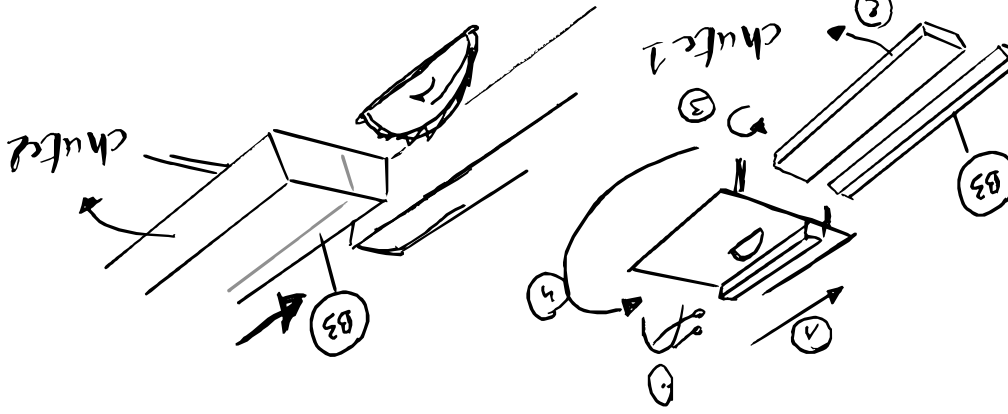
[picture p112: figure]

(à 1-2 mm près).

la table de Pour l'assemblage des piliers, nous allons utiliser

). On place les fourrures, E - Marbres montage (voir notice tion, le B3 enduites de colle PU, sur un côté du montant B1 (atten

sur table On va venir déligner ces pièces à l'aide de la scie

). Il faut d'abord découper les deux pièces aux notice Z ( rapport à la extrémités (B3). La lame est positionnée à 15° par base fasse verticale puis placer la butée de sorte à ce que la

49mm.

retourner la Une fois la première pièce B3 découpée, il suffit de la et de la passer sur la scie sur table pour obtenir chute 1

deuxième B3.
