mors-es/maison-petales/notices/d_toiture_print.pdf

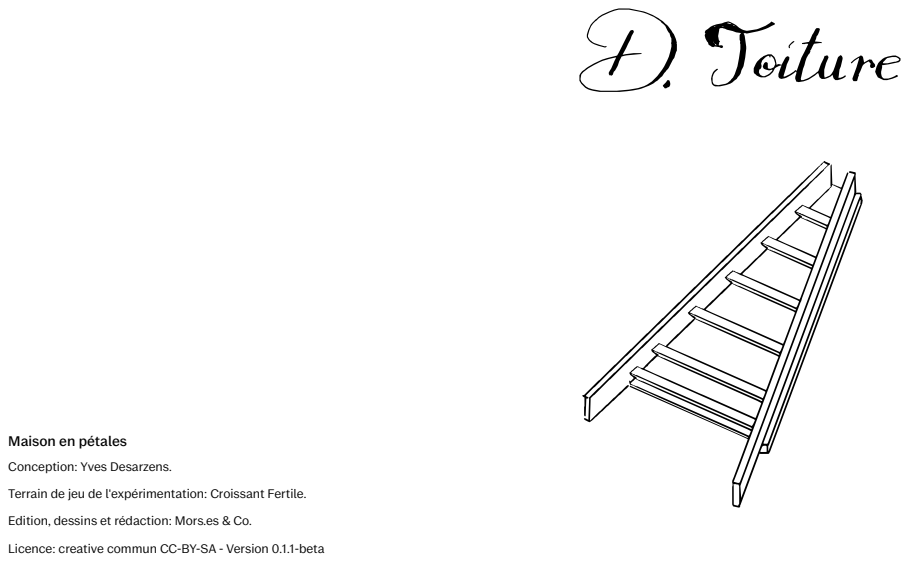
[picture p113: page 1]

Maison en pétales

Conception: Yves Desarzens.

Terrain de jeu de l'expérimentation: Croissant Fertile.

Edition, dessins et rédaction: Mors.es & Co.

Licence: creative commun CC-BY-SA - Version 0.1.1-beta

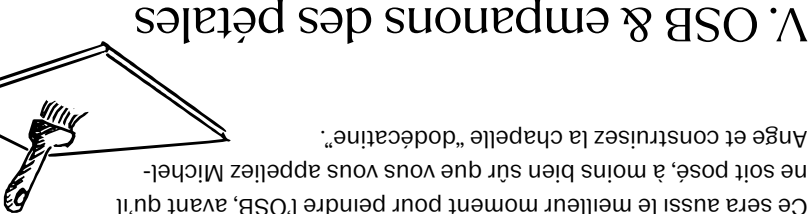
[picture p114: figure]
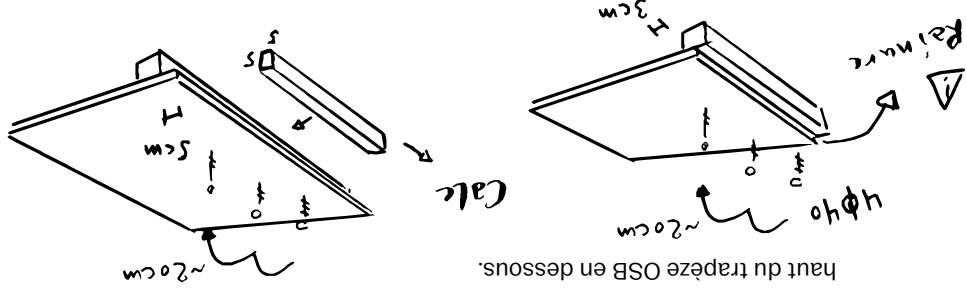
[picture p115: figure]
haut du trapèze OSB en dessous.

uper les Après avoir découpé les empanons, on doit aussi déco des contre-lattes (D3 et D4). reprises

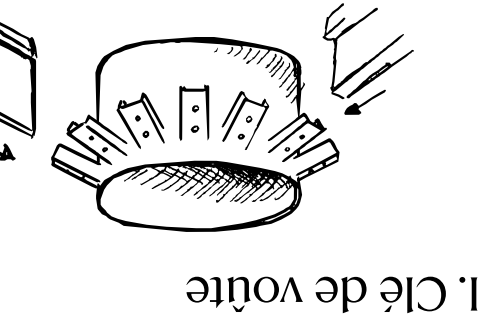
[picture p116: figure]

Assemblage

n OSB. On vient fixer les empanons sur le bas des trapèzes e ur accueillir le Elles dépassent la moitié de leur largeur (3 cm) po accueillera A l'exception du premier trapèze (DOSB1) qui, lui, ut aider). son empanon à 5 cm de son bord (utiliser une cale pe

, avant qu’il Ce sera aussi le meilleur moment pour peindre l’OSB z Michel- ne soit posé, à moins bien sûr que vous vous appelie

Ange et construisez la chapelle “dodécatine”.

Y - livret Les pièces se fabriquent de manière identique (voir

) simplement ce sont de trapèzes rectangles Plans & Débits

(avec un angle droit).

vants : Une clé Les éléments structurels de la toiture sont les sui ainsi que des plaques OSB avec leur arbalétriers de voûte , 12

“pannes" qui viennent entre les arbalétriers.

st conseillé de C'est la seule pièce de la Maison en Pétale qu'il e el. Il s'agit faire faire par un soudeur ou ferronnier professionn est cette d'une pièce métallique assez complexe et centrale. C' pièce qui vient accueillir les 12 arbalétriers.

t pas Néanmoins, avec de bonnes notions de soudure ce n'es se impossible. Si le défi vous tente, les plans techniques

. Y - Plans & Débits trouvent dans la notice é de voûte. Ils Les 12 arbalétriers sont reliés au milieu par la cl au sommet (B2 et B3) fourrures viennent s'encastrer entre les

). B - Piliers des piliers (voir notice

Découpes

Les différents trapèzes se découpent dans des panneaux d'OSB de 12mm de 67,5 cm par 200 cm. En arrangeant correctement plusieurs panneaux ensemble on va pouvoir minimiser les

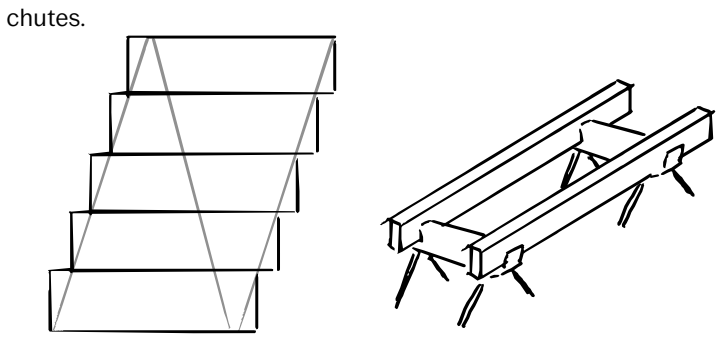
[picture p117: figure]
chutes.

La surface de travail se doit d'être plane et pouvant être martyrisée. Ça peut être deux bastaings sur des tréteaux de charpentier. Mais la table de montage (notice E) peut aussi être utilisée.

A l'aide d'une scie plongeante et de son rail les découpes se font assez simplement. Après avoir tracé les lignes de coupe, le rail vient se positionner dessus et on vient régler la butée de la scie à 12 mm (épaisseur de l'OSB) .

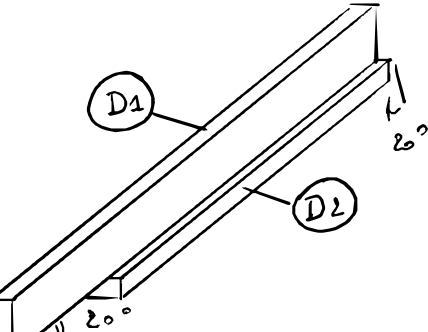
[picture p118: figure]

Découpes

Ils sont composés de deux pièces vissées-collées. Qui sont tous les deux découpés avec deux angles parallèles de 20°, l'un sur sa largeur (D1) et l'autre sur l'épaisseur (D2).

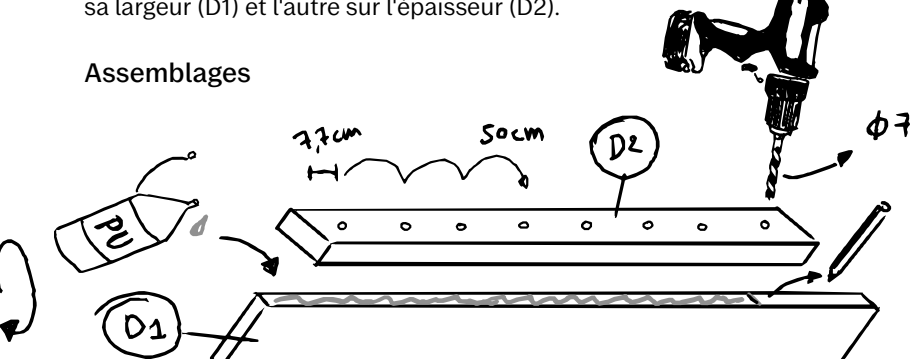
[picture p119: figure]
Assemblages
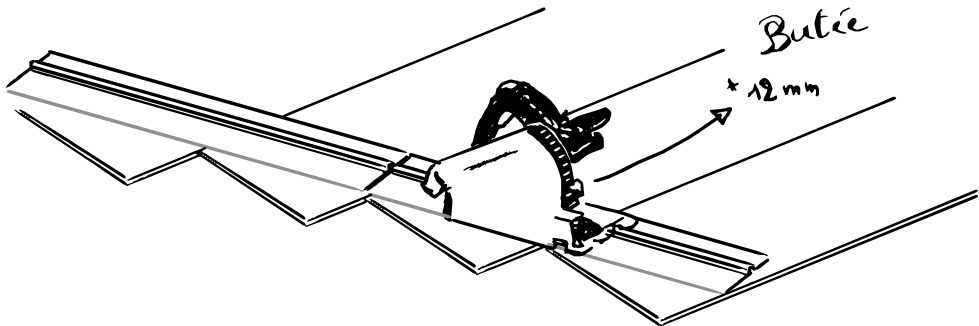
[picture p120: figure]

Pour l'assemblage il est important de pré-percer la fourrure (D2) de 8 trous avec un foret de 7 mm. c'est l'occasion de choisir la plus belle face de la fourrure car elle sera visible de l'intérieur.

Sur la tranche de la pièce principale (D1) que va être collée, on peut marquer la mesure de la fourrure et enduire d'une bonne couche de colle PU.

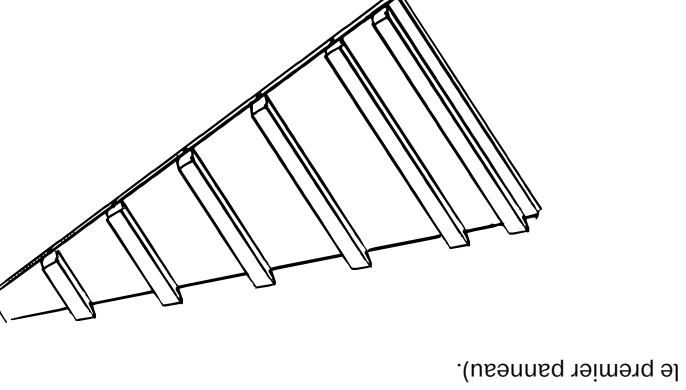
[picture p121: figure]
le premier panneau).

létriers du Ils se fabriquent de manière très similaire aux arba e à ras bord pistil. Seule différence: la fourrure n'est pas placé

mais un peu plus bas.

lir les Les fourrures des arbalétriers sont là pour accueil

Pétales panneaux d’OSB qui seront le plafond de la Maison en e. Pour rigidifier et sur lesquels sera posée l'isolation de la toitur fixer des les panneaux et éviter leurs flambements on va venir sauf pour pannes en bois brute 6x6 cm au niveau des jonctions (

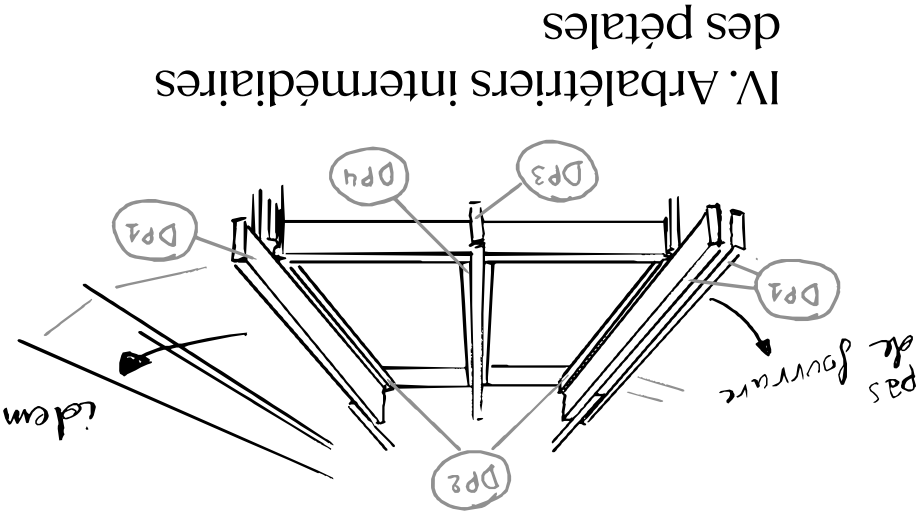
[picture p122: figure]

pour plus On peut retourner les pièces D1 sur sa fourrure (D2) ales de 30 de stabilité. On centre le montant (D1) à l'aide de c e la pièce mm d'épaisseur qui sont placées de part et d'autre d

100) à la ⌀ de bois. On vient ensuite visser 8 longues vis (8

visseuse.

débordé à l'aide Une fois la colle prise, il faut nettoyer ce qui a a face d'un ciseau à bois. On peut également venir poncer l les casser visible de la fourrure avec une ponceuse à bande et les vis arêtes.Le mieux serait de le faire préalablement, car

gênent le ponçage.

s premiers Pour les pétales il y a deux types d'arbalétriers, le

. (DP1) viennent prolonger les arbalétriers du pistil us eux sont A deux, ils viennent en sandwich sur ces derniers. So ntérieur du vissé-collé une fourrure (DP2) qui dépasse vers l'i de pétales alors pétale. Si l’arbalétrier est le dernier d'une série

il n'a pas de fourrure.

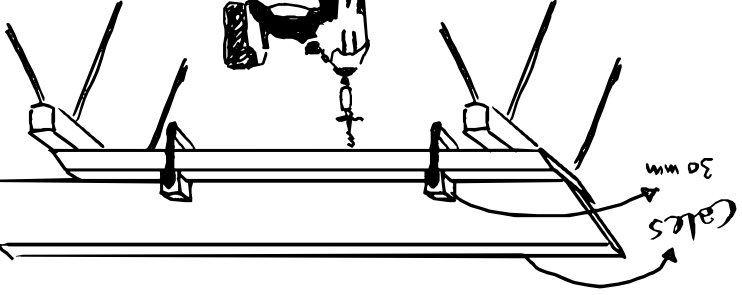
[picture p123: figure]
