mors-es/maison-petales/notices/1_fondations_print.pdf

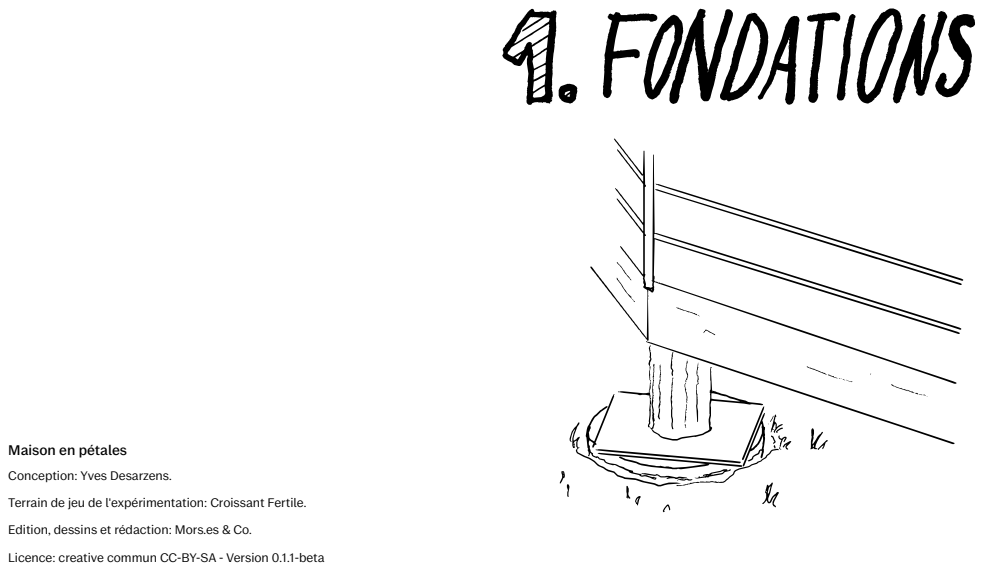
[picture p124: page 1]

Maison en pétales

Conception: Yves Desarzens.

Terrain de jeu de l'expérimentation: Croissant Fertile.

Edition, dessins et rédaction: Mors.es & Co.

Licence: creative commun CC-BY-SA - Version 0.1.1-beta

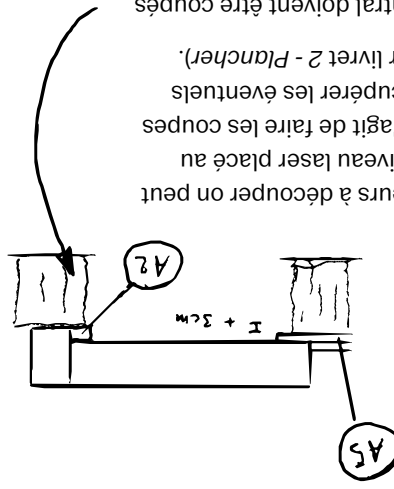
[picture p125: figure]

e le lien entre Il va falloir maintenant créer des supports pour fair us de la les poutres de fondation du plancher (A1) et les pne rs sont loin fondation. En effet, même sur terrain plat, ces dernie

d'être à niveau.

aqué pour Dans un premier temps on pourra utiliser du contrepl répartir la charge sur les pneus, celui-ci pourra être ous imperméabilisé avec du vernis marin, puis par-dessus n e plaçons des troncs de 30 cm de diamètre et si possibl

d’essence imputrescible.

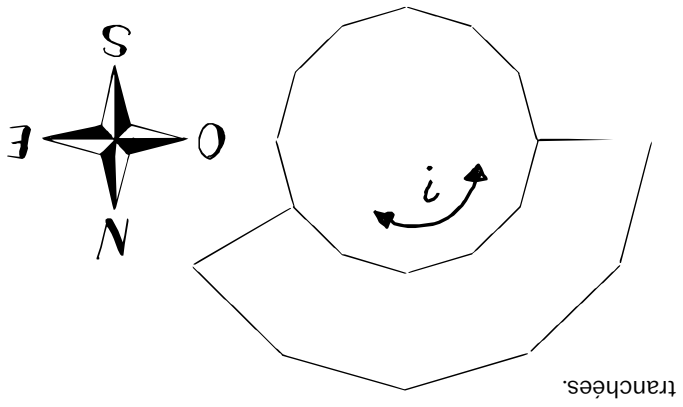
[picture p126: figure]
tranchées.

on peut Afin de connaître les différentes longueurs à découper r placé au les déterminer à l'avance à l'aide d'un niveau lase e les coupes centre et d'un simple bâton de bois. Il s'agit de fair éventuels les plus droites possibles.On pourra récupérer les

). 2 - Plancher erreurs lors de la pose du plancher (voir livret t être coupés Attention les troncs pour le plateau central doiven cm alors 3 cm plus haut car la solivette (A2) est épaisse de 6

3 cm. que le plateau central lui, n’a qu’une épaisseur de

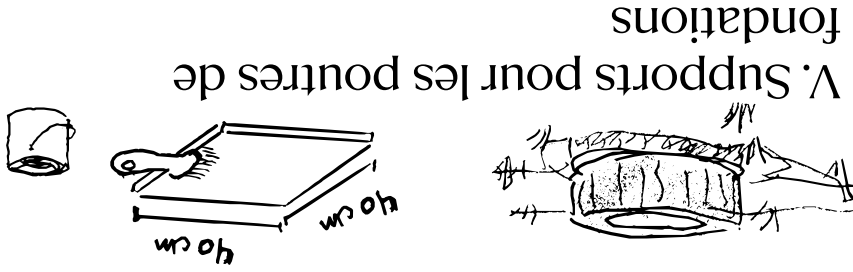
[picture p127: figure]

ison en C'est parti ! On se lance dans l'édification d'une Ma rais même Pétales. Mieux vaut partir sur de bonnes bases, je di plus de bonnes fondations.

étant pas "si À moins de vivre sur un rocher, la Maison Pétales n' mum de légère", il est toujours nécessaire de faire un mini

, il est donc fondation. Nous parlons d'un habitat dit "réversible" qui le sont question de mettre en place des pieds de fondations une tout autant. Dans les pages suivantes sera présentée ais il méthode sur pneus mis en œuvre au Croissant Fertile. M e des existe de nombreuses autres méthodes, notamment cell qui sera sans doute documentée dans le futur. Krinner vis ent dans le Positionner un habitat sur un terrain et plus largem guments paysage est une chose qui se réfléchit. Sur base d'ar demander des rationnels ou plus subjectifs, il peut être utile de avis extérieurs (architectes, paysagistes, famille,...).

rentes C'est aussi à ce moment qu’il faut penser aux diffé s des entrées (eau, électricité,...) pour envisager le parcour

On va maintenant creuser pour atteindre le sol minéral. La partie organique supérieure du sol peut varier de 10 à 60 cm en fonction des sols. On gardera une partie de la terre non organique sur le côté.

Une fois qu'on est satisfait du trou on peut placer un géotextile au fond pour éviter que la terre ne sorte des pneus. Le premier pneu est alors placé dans le fond du trou qui sera rempli de terre non organique ou de sable. Il est important ici de bien tasser la terre dans le pneu à l'aide d’un bâton ou d’une masse. Si le trou est très profond on peut ajouter un deuxième pneu pour s'approcher du niveau du sol.

Ensuite, un dernier pneu est ajouté mais cette fois-ci il sera rempli de gravier afin d'éviter toutes remontées capillaires.

Quitte à creuser, cela peut être l'occasion de faire les tranchées pour les arrivées d'eau et d'électricité.

Une fois que l'on sait où l'habitat sera positionné, le plus simple est de repérer les points cardinaux (Nord, Sud, Est et Ouest).

À l'aide de pieux et de cordes, on commence par symboliser l'axe Nord-Sud.

On indiquera le centre avec un pieu. Ce sera le centre du "pistil". Il existe plusieurs possibilités pour "dessiner" l’axe perpendiculaire Est-ouest. Le plus simple est de partir des dimensions du cercle circonscrit du pistil de la Maison en Pétales.

Avec le théorème de Pythagore il suffit alors de prendre une corde de la taille du rayon et un autre représentant l’hypoténuse du triangle pour marquer l'Est et l'Ouest.

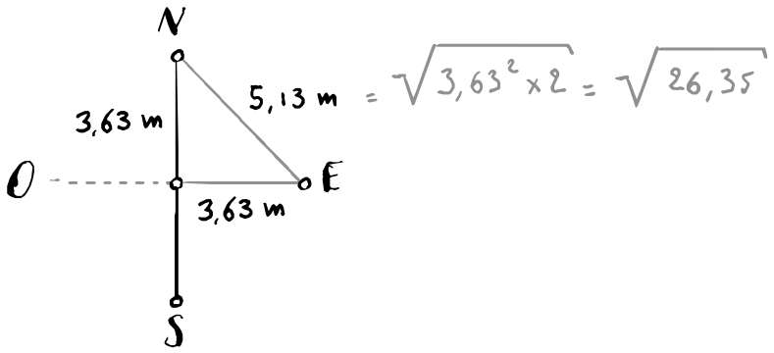
[picture p128: figure]

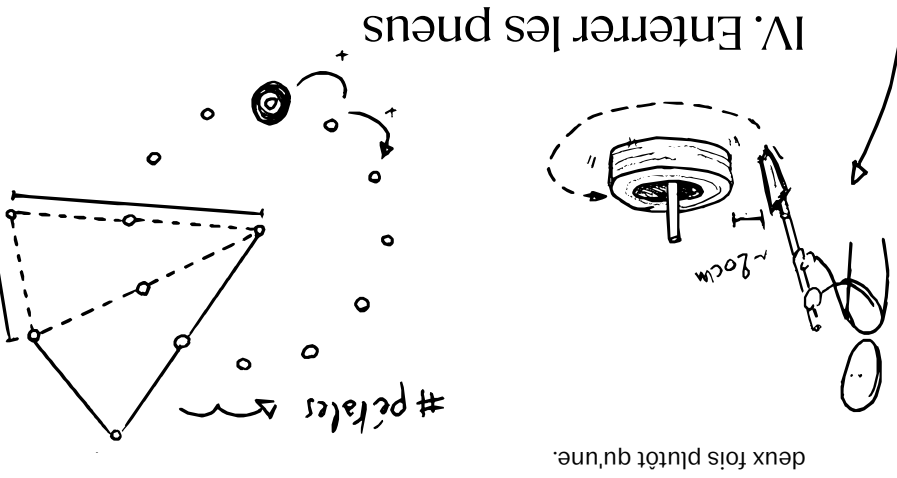
[picture p129: figure]
deux fois plutôt qu'une.

c un rayon Même chose pour les pétales, mais cette fois-ci ave n faites, les et des côtés plus grands. Si les mesures ont été bie ar l'un des rayons des pétales devraient à chaque fois passer p pas à mesurer pieux du pistil mais de manière générale n'hésitez

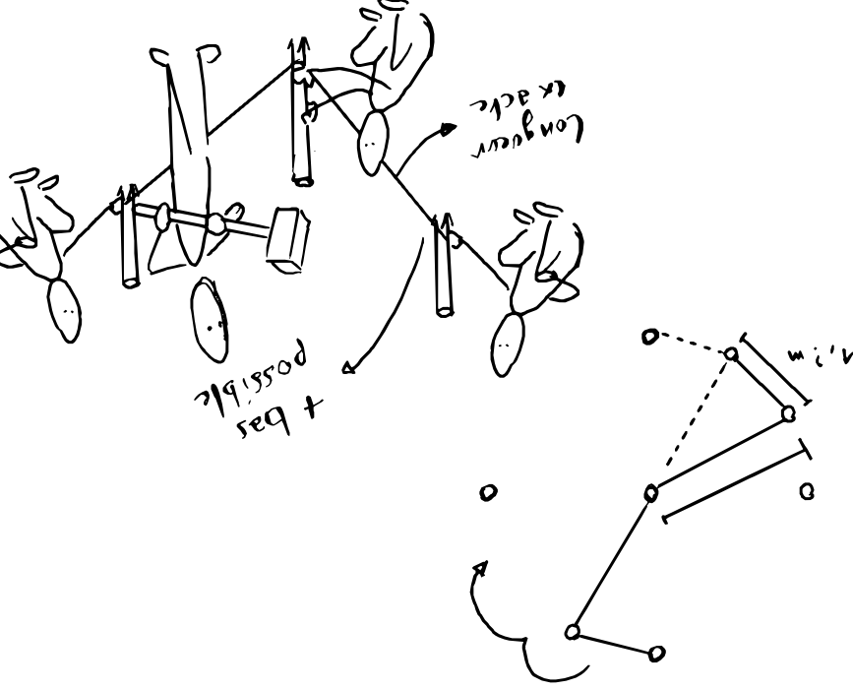
[picture p130: figure]

ation de Nous avons maintenant l'ensemble des points de fond nés des la Maison en Pétales. À chaque pieux seront position neus seront pneus superposés, à l'exception du centre où trois p mis autour du pieu central.

le pneu avec le Pour indiquer la zone à creuser il suffit de mettre marge (~20 pied au centre et de creuser autour avec une bonne e on peut cm). Pour garder en mémoire les points du dodécagon ux, ou si on le positionner des pieux en retrait des pieux principa souhaite, marquer à la bombe le cercle circonscrit.

notre Une fois fait, on va pouvoir tracer les 12 côtés de rayon et dodécagone en reprenant notre corde de la taille du

On va avec une deuxième corde de la taille d'un des côtés.

d'un des pouvoir faire une série de petits triangles en partant

points cardinaux.

et pour Il faut bien que les cordes aient la dimension exacte ordes le plus bas éviter les erreurs il est conseillé de placer les c on peut possible sur les pieux. Pour accélérer le processus, travailler en plusieurs groupes.
