mors-es/maison-petales/notices/2_plancher_print.pdf

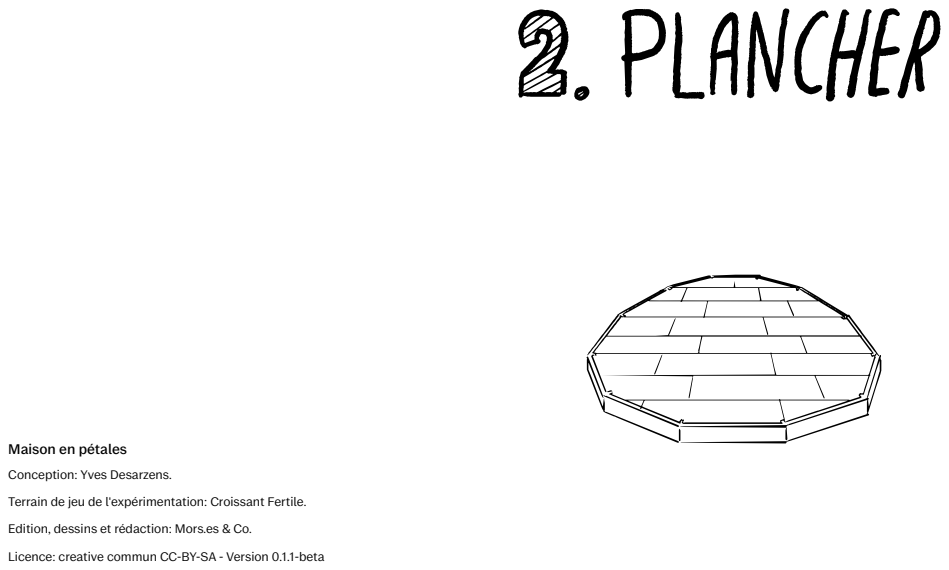
[picture p131: page 1]

Maison en pétales

Conception: Yves Desarzens.

Terrain de jeu de l'expérimentation: Croissant Fertile.

Edition, dessins et rédaction: Mors.es & Co.

Licence: creative commun CC-BY-SA - Version 0.1.1-beta

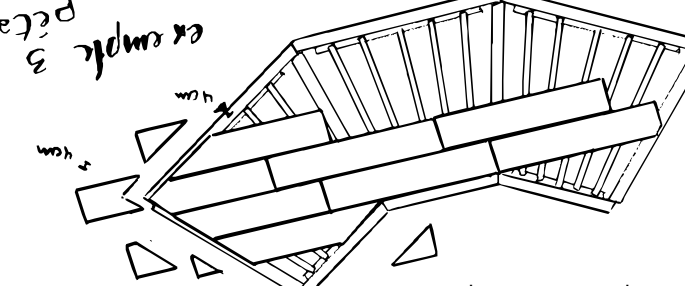
[picture p132: figure]

au centre et Il y a deux types de solives par pétale. Trois courtes deux légèrement plus longues aux extrémités. De la même e de vis de manière que pour le pistil on vient les fixer à l'aid

80. ⌀6

olives et qu’il Il faut que l’OSB soit le plus perpendiculaire aux s

). On notice 3 r se place une fois la structure du pistil monté (voi

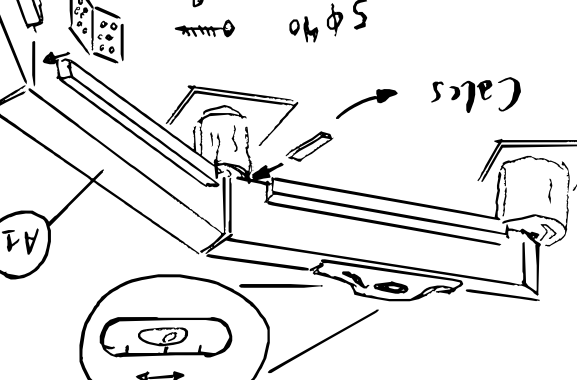
[picture p133: figure]

adre du commence à poser les premières plaques le long du c ntinue la pose pistil donnant sur le pétale central. Ensuite on co

’OSB. De la en allant vers l’extérieur de cette première ligne d arrêtent à même manière que pour le pistil les plaques d’OSB s’

4 cm du périmètre des pétales.

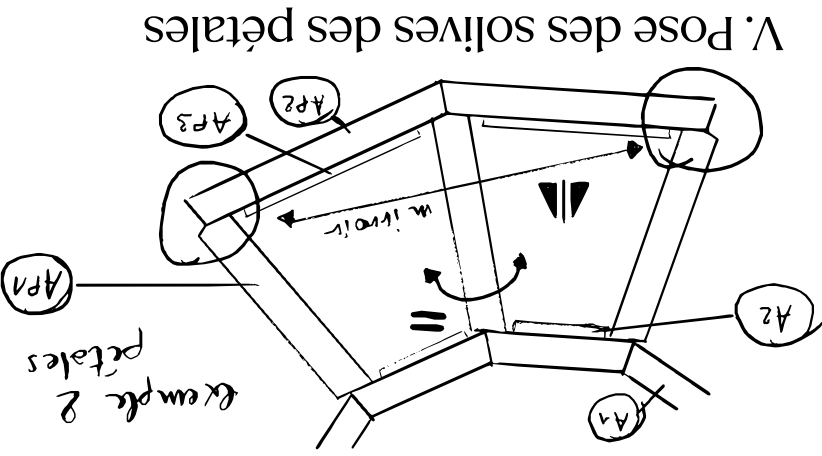
[picture p134: figure]

e (vis ou Maintenant que les points de fondation sont en plac

) on va pouvoir commencer à 1 - Fondations pneus, voir notice en construire à proprement parler la Maison en Pétales, commençant par le plancher.

er une En commençant par le point le plus haut, on vient plac de par une les poutres de fondations entre deux points que chaque fondation. A l'aide d'un niveau à bulle, on s'assure ir placer de poutre est bien placée horizontalement, quitte à ven res sont fines cales si nécessaire sous les poutres. Les pout ensuite reliées à l'aide de plaques métalliques.

l faut le faire Trouver le point le plus haut peut-être compliqué, i u à bulle ou à tâtons avec une grande règle de maçon et un nivea à l'aide d'un niveau laser.

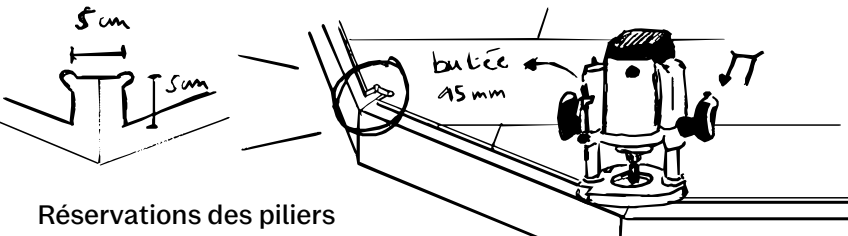
[picture p135: figure]
Réservations des piliers

Pour que le montant central des piliers (B1) puisse reposer sur les poutres de fondation, il faut enlever un carré de 5 cm par 5 cm.Le plus simple est de le faire à la défonceuse, mais il faut alors penser à bien creuser les angles.

De manière similaire au pistil on place les poutres de fondation bien à niveau les unes par rapport aux autres.

Il y a deux types de poutres de fondation (voir notice A -Plancher). Il y a d’abord les poutres rayons qui viennent se remettre dans les angles du pistil.

Les poutres rayons qui sont aux extrémités des pétales sont positionnées en miroir de façon à ce que l'épaisseur la plus grande soit vers l'intérieur des pétales. Les poutres rayons intermédiaires quant à elles peuvent être positionnées de la même manière que l’une ou l’autre des poutres latérales.

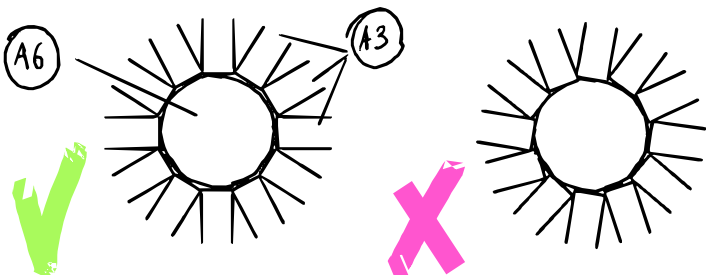
[picture p136: figure]

Ensuite les poutres de fondation extérieures sont positionnées de manière similaire à celles du pistil.

Lors de la fabrication des pièces du plancher il ne faut pas oublier d'ajouter les solivettes à la fois sur la poutre de fondation extérieure mais également à l'extérieur des poutres de fondation du pistil qui vont accueillir les solives du plancher des pétales.

On vient poser le plateau central au centre du cercle sans le fixer (A5/A6). Ensuite on vient poser les 4 premières solives courtes (A3) de manière perpendiculaire.

Il est possible que les solives n'arrivent pas correctement en butée. Cela signifie que le cercle a une forme ovoïde. Si c'est le cas, il suffit de taper sur le périmètre externe pour reformer le

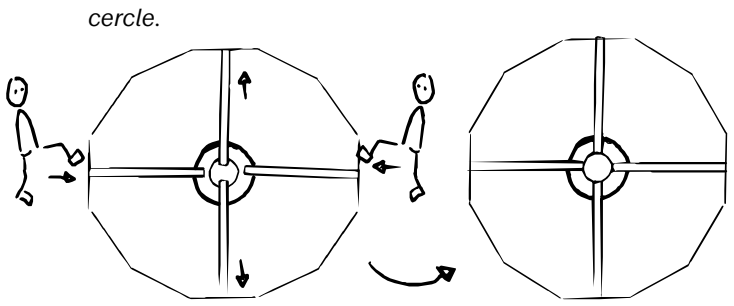
[picture p137: figure]
cercle.

Ensuite, on place les solives courtes restantes (A3) en miroir tout autour du cercle délicatement. Le centre du cercle doit avoir une allure de rayons de soleil et non d’une spirale, mais ce n'est pas non plus nécessaire que ce soit parfait.

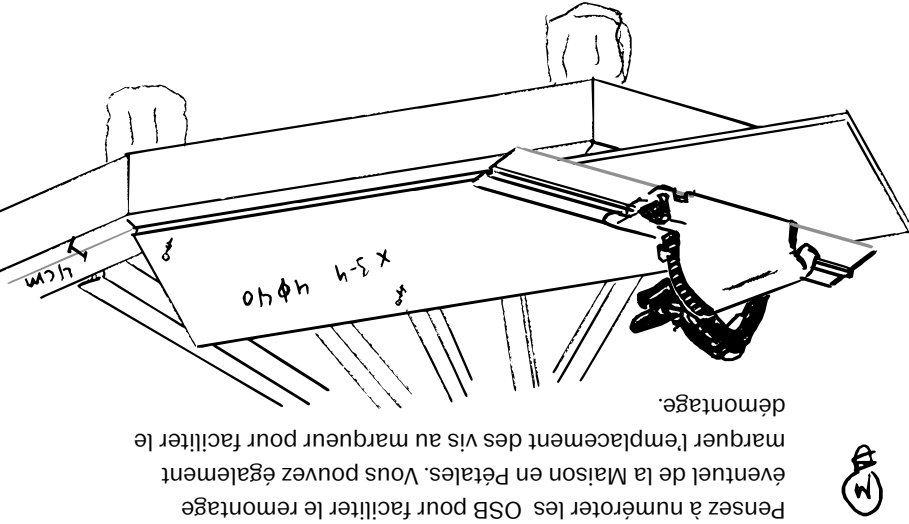
[picture p138: figure]
démontage.

s poutres de À l'aide d'une règle de maçon on vient tracer sur le tres. Ensuite, fondation un repaire à 4 cm de l'extérieur des pou ue en commençant par un côté, on pose une première plaq s d'OSB d'OSB le long du tracé. Puis, en quinconce, les plaque

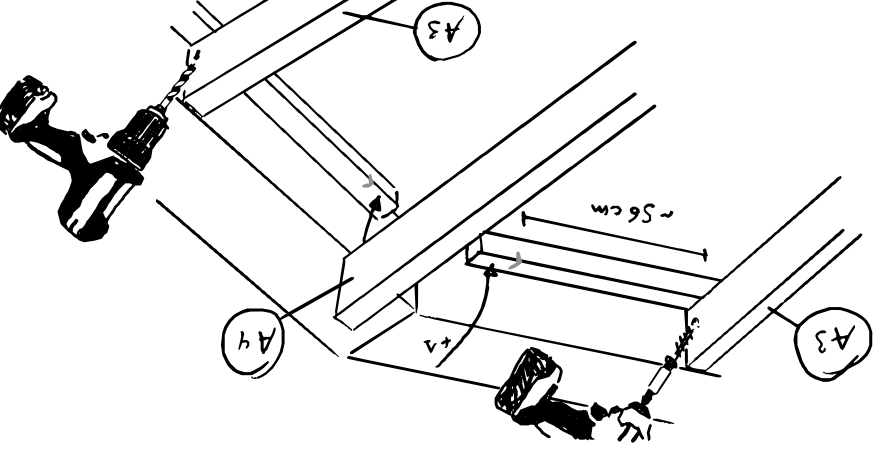
[picture p139: figure]

le aux sont assemblées par-dessus. Il faut les fixer si possib de 3 à 4 vis poutres de fondation sinon sur les solives à l'aide d des maximum. Attention de ne pas visser trop près du bor

plaques.

eur de 15 à 16 A l'aide de la scie plongeante réglée à une profond cm. mm on vient couper les plaques le long du trait de 4 s pourront Les angles n’étant pas constants, les premières chute tte procédure être utilisées vers la fin de la pose du plancher. Ce ont est liée à la forme du plancher: dès que les chutes s ute du bout insignifiantes, adoptez la procédure habituelle: la ch de la ligne (n) d’OSB est le début de la ligne (n+1).

tage Pensez à numéroter les OSB pour faciliter le remon ment éventuel de la Maison en Pétales. Vous pouvez égale iter le marquer l’emplacement des vis au marqueur pour facil

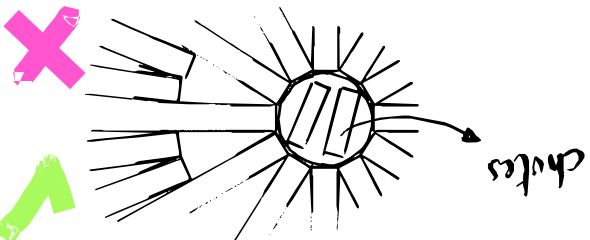
[picture p140: figure]

vettes (A2) Enfin, les solives longues (A4) sont fixées sur les soli ngues, on des poutres de fondation. Pour placer les solives lo cm. Pour aura au préalable fait une marque à la mesure de 56,5 ec un angle à maintenir les solives on pré-perce ces dernières av suite fixer leur base à l'aide d'une mèche de 6 mm et on vient en une visseuse. le tout à l'aide de vis de 6 mm par 80 mm à l'aide d’ rectement Il est facile de vérifier que les solives ont été cor entral en placées au niveau du périmètre à l'allure du rond c observant l'alignement des bouts de solives.

entre du On peut également ajouter des chutes de solives au c central au plateau central si il est prévu d'ajouter un poteau pistil (pour une éventuelle mezzanine par exemple).
