mors-es/maison-petales/notices/3_structure_print.pdf

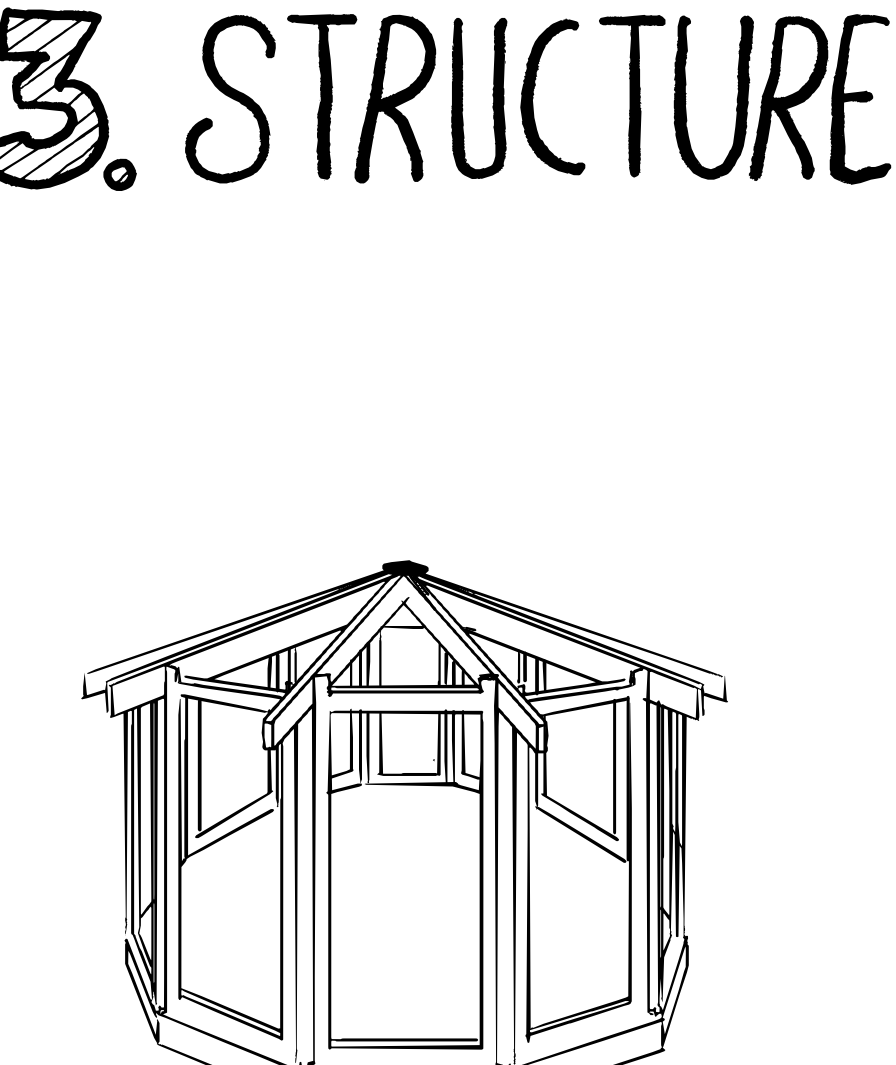
[picture p141: figure]

Cadres latéraux

Les cadres latéraux des pétales viennent se positionner sous les bouts des arbalétriers du pistil. Il peut être nécessaire de soulever légèrement ces derniers avec, par exemple, un cric ou un bras de levier. Ensuite, ils viennent se poser comme pour le pistil, au bord des poutres de fondations sur l'OSB du plancher qui aura reçu ses bandes d'étanchéité. Ils sont sécurisés avec de longues vis de 8 par 200 mm sur les piliers du pistil.

Arbalétriers

Les arbalétriers viennent en sandwich autour des arbalétriers du pistil et des piliers/cadres latéraux des pétales. Pour les solidariser , on vient mettre deux longues tiges filetées de 17 cm et de 8 mm de diamètre. Les arbalétriers intermédiaires eux sont maintenus au sommet par des petites cales et dans le bas, on vient entailler la lisse haute et on ajoute des petits montants pour supporter l'OSB qui vient protéger l'isolation.

Maison en pétales

Conception: Yves Desarzens.

Terrain de jeu de l'expérimentation: Croissant Fertile.

Edition, dessins et rédaction: Mors.es & Co.

Licence: creative commun CC-BY-SA - Version 0.1.1-beta

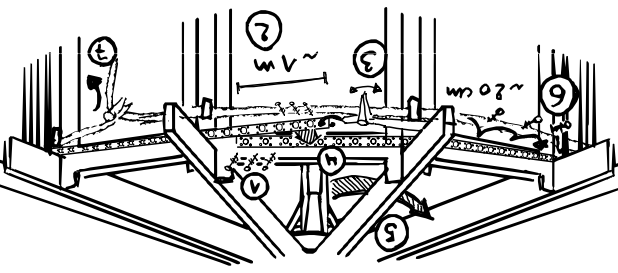
[picture p142: figure]

emporaire, on Une fois tous les arbalétriers posés sur le pilier t ers après vient amener la clé de voûte au centre des arbalétri teau. Pour avoir dévissé les quelques arbalétriers fixés au pla aire de surélever faciliter l'entrée de la clé de voûte, il est nécess nnera à le pilier central. Pour ça un cric de voiture fonctio maintien et merveille. On va aussi devoir resserrer la sangle de bien centrer possiblement devoir taper sur certains piliers pour on vient les arbalétriers. Quand la clé de voûte est en place

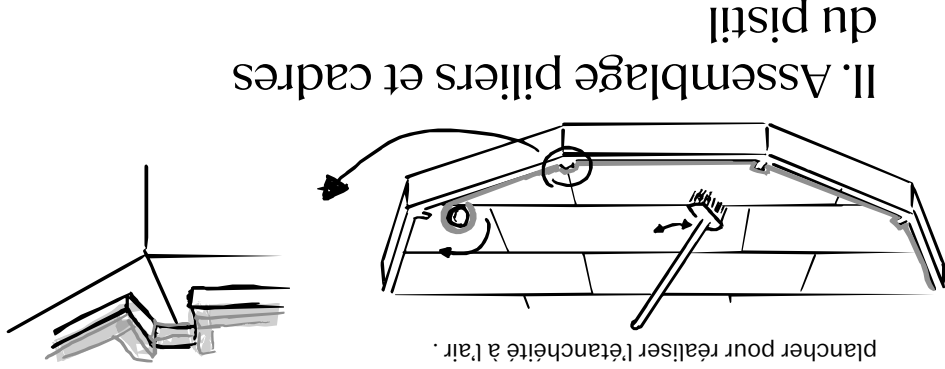
[picture p143: figure]

100, en ⌀ 6 visser les ailerons aux arbalétriers avec des vis de biais de manière à tirer ces derniers vers la clé.

Pose du feuillard

rd sécuriser Avant de retirer le pilier temporaire, il faut d'abo dessus de la définitivement la structure. Le feuillard se pose au-ôté est sangle, le long des lisses hautes des cadres (CX). Un c

40 (1), on fait le tour avec le feuillard et on ⌀ fixé avec 10 vis de 4 ne sangle et prend 1m de plus que le périmètre (2), en prenant u euillard (3). en agrandissant le dernier trou, on peut tendre le f ts, on vient Lorsqu'on est satisfait de la verticalité des montan ne de vis (4) et fixer l'autre bout du feuillard avec aussi une dizai e le feuillard en on peut retirer le pilier central qui va alors mettr etits trous tension (5). On vient enfin mettre des vis dans les p du feuillard (haut/bas) tous les 20 cm environ (6).

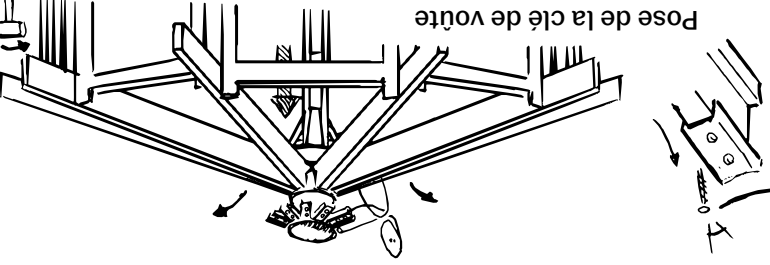
[picture p144: figure]
Pose de la clé de voûte

n Pétales. C’est l'étape la plus impressionnante de la Maison e e de la Mais au final sans doute la plus rapide : L'assemblag

structure.

a notice On en reparlera de l’étanchéité plus longuement dans l rativement , mais avant le montage de la structure, il faut impé 5 l'OSB du coller un bande de mousse expansive sur le bord de plancher pour réaliser l’étanchéité à l’air .

r. Les On commence par monter un premier cadre et un pilie

C - ce cadres vides avec leurs contreventements (voir noti deux. ) se portent à minimum 4 personnes, et les piliers à Cadres

Il faut essayer d'endommager au minimum la bande

d’étanchéité.

La sangle est ensuite tendue légèrement (il faut que la structure puisse toujours être un peu mobile). On peut alors retirer les arbalétriers qui étayaient la construction. .

Attention : à partir du montage de la charpente, il ne faut pas retirer la sangle avant la pause du feuillard.

Monter les arbalétriers

Pour monter les arbalétriers, on va utiliser le Pilier de support temporaire (voir notice E - Marbres). Il faut minimum 2 personnes pour le maintenir au centre du pistil. Il peut être utile de construire une structure échafaudée à proximité de ce dernier pour le maintenir temporairement le temps de monter les arbalétriers. Ensuite on vient monter les arbalétriers deux par deux en miroir. Le bas de l'arbalétrier est d'abord posé sur le montant central d'un pilier (B1) et ensuite positionné sur le plateau rond du pilier temporaire. Il est conseillé de venir visser les premiers arbalétriers au plateau pour éviter qui tombent.

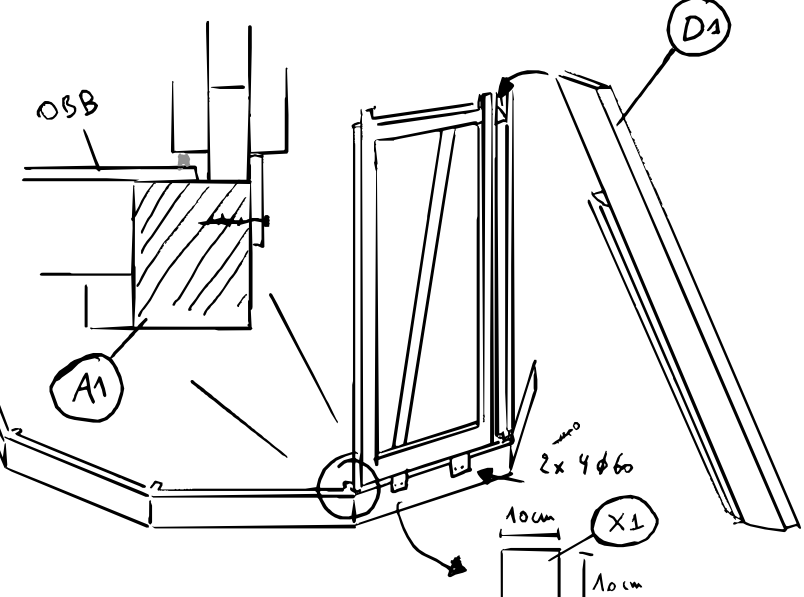
[picture p145: figure]

Il s'agit d'une étape assez critique, il vaut mieux avoir 1 ou 2 bon échafaudage pour monter facilement les arbalétriers. Seules les personnes qui montent les pièces doivent être présentes. Les casques de chantier sont vivement conseillés.

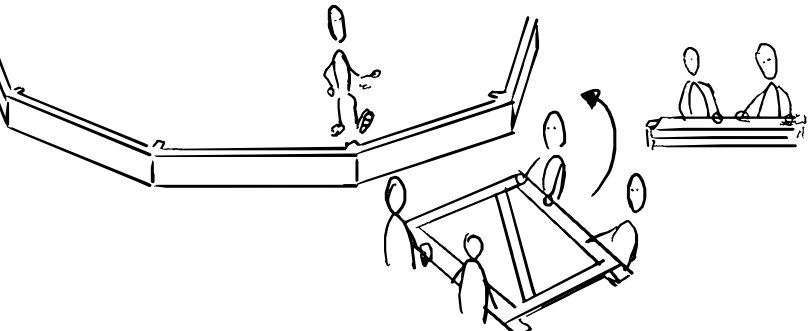
[picture p146: figure]

La partie intérieure du cadre vient se poser sur l'OSB. La lisse basse centrale (C1) vient se poser sur la poutre de fondation, sa face extérieure alignée au bord extérieur de la poutre de fondation (A1). Au début la structure est assez instable, on peut alors utiliser les arbalétriers et les glisser aux sommets des piliers comme une “béquille”.

Pour empêcher le cadre de sortir, deux petites plaques sont visées sur la poutre de fondation (A1).

bas, ils peuvent Si c'est trop difficile de placer les piliers par le être "enfilés" par le haut.

Sangle de maintien

faut sécuriser la Avant de monter les arbalétriers sur la torture il une sangle structure. Pour ça, on va sangler l’ ensemble (avec maintenir de 25m ou plusieurs attachées l’une à l’autre). Pour ts supports ces dernières, on aura préalablement vissé des peti lisse haute des sur le haut des piliers juste sous le niveau de la

cadres.

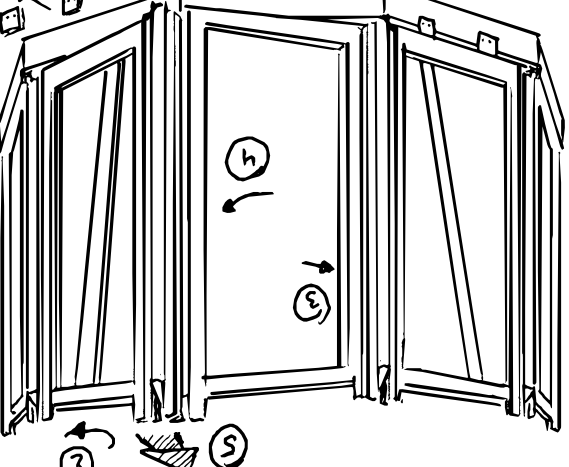
[picture p147: figure]

uivant. Vient Une fois le cadre posé, on peut enquiller le pilier s

, le plus près ensuite le cadre d'après. Il est posé à côté du pilier

. Si vous rencontrez fourrures possible puis encastré dans les dez où ça une difficulté au montage, 1. prenez du recul 2. regar quence. bute: la pièce a-t-elle un défaut? 3.agissez en consé

, de masse ou Suivant la situation, aidez-vous de sangle à cliquet

de pied de biche.

ts Pour maintenir encore mieux l'ensemble, des serre-join peuvent maintenir 2 cadres ensemble. Ou un montant et au d'ossature peut être temporairement fixé à un cadre plancher pour compléter le maintien.

t parallèles. Les cadres et les piliers doivent être verticalemen l'intérieur du On peut venir pousser le pilier vers l'extérieur ou

pistil pour corriger ça.

Dernier cadre

les cales de Pour venir assembler le dernier cadre, on va enlever ement le maintien du premier cadre (1) et venir écarter légèr placé dans les pilier et le cadre (2). Ensuite, le dernier cadre est premier du dernier pilier (3) et glisser dans le pilier du fourrures au du cadre (4). Finalement on repousse l'ensemble au nive

plancher (5).

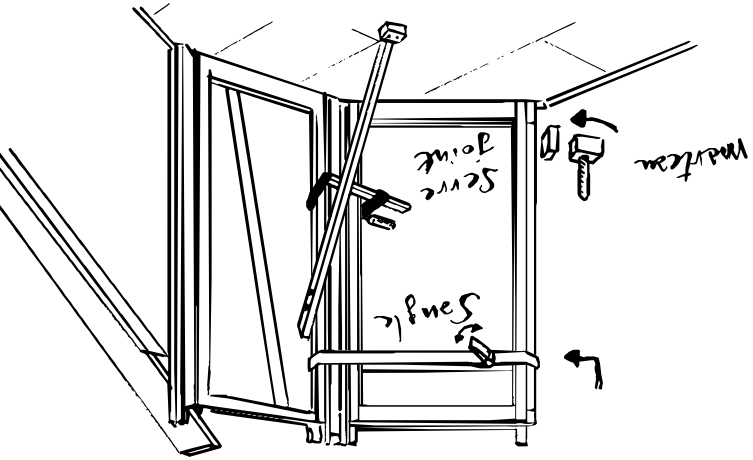
[picture p148: figure]
