mors-es/maison-petales/notices/c_cadres_print.pdf

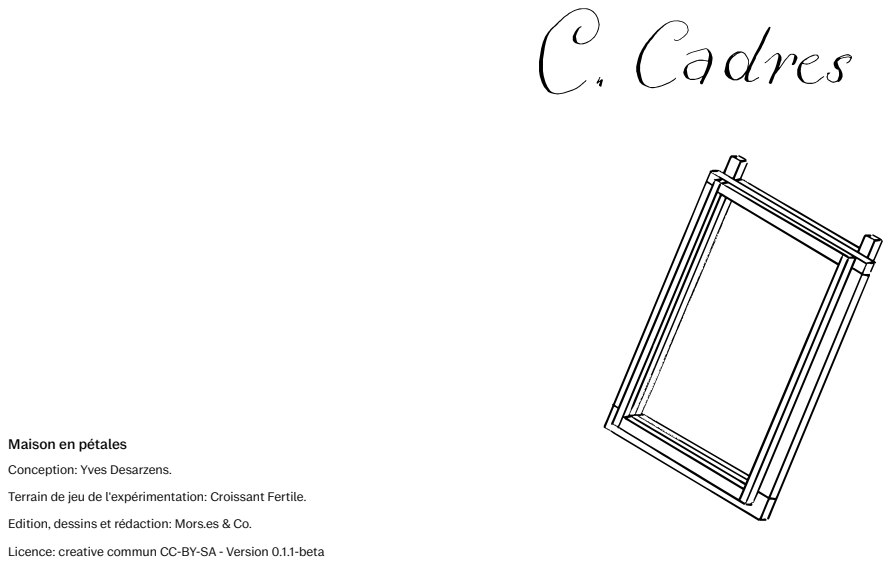
[picture p149: page 1]

Maison en pétales

Conception: Yves Desarzens.

Terrain de jeu de l'expérimentation: Croissant Fertile.

Edition, dessins et rédaction: Mors.es & Co.

Licence: creative commun CC-BY-SA - Version 0.1.1-beta

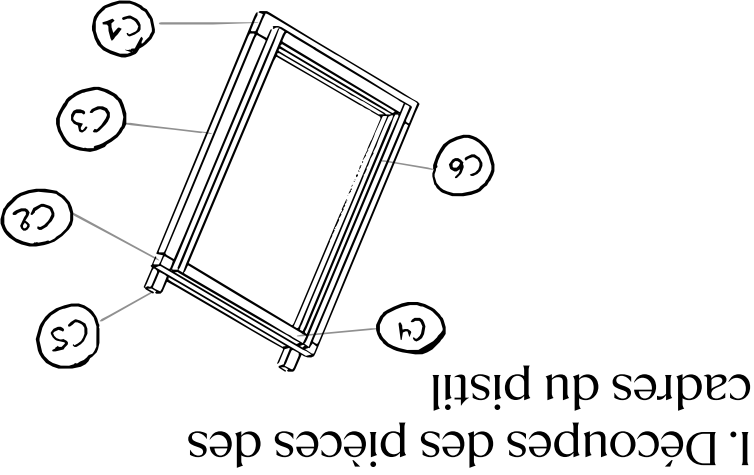
[picture p150: figure]

rent" une Les cadres latéraux sont les deux cadres qui "encad mes série de pétales successifs. Ils sont composés des mê re. pièces mais sont construits en miroir l'un de l'aut emblage Comme pour les cadres précédents il s'agit d'un ass otables on triple couches collé-cloué. Parmis les différences n

, lisses hautes notera une pente de 20° au niveau des ent une permettant de suivre la pente du toit. Ils ont égalem montage taille très importante. Ils dépasseront de la table de ent mais sans que ce soit réellement handicapant. Ils peuv r du pistil. également être réalisés sur chantier sur le planche

. Attention à bien les contreventer pour les déplacer qui fait la jonction avec les cadres montant Enfin sur le petit

. Ces dernières ont fourrures extérieurs pétales on va ajouter des

. B - piliers été découpées dans la notice

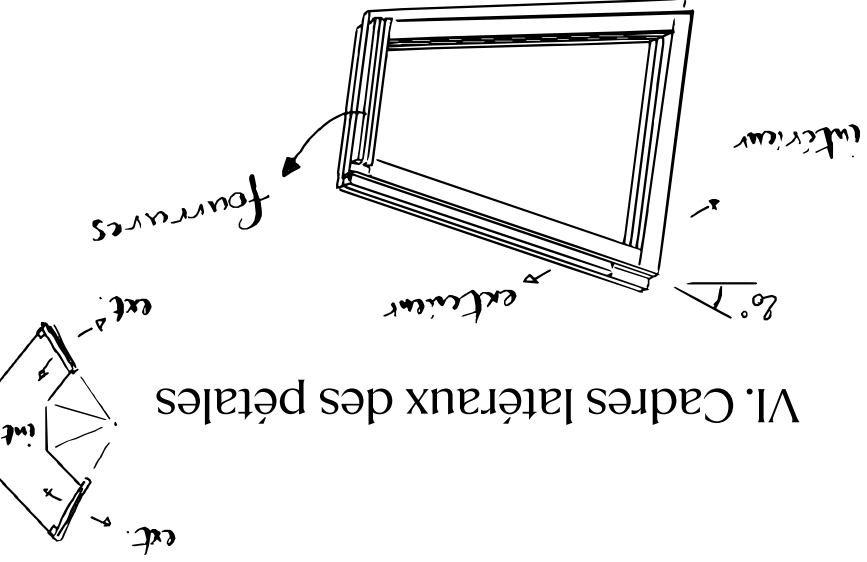
[picture p151: figure]

les structures des parois qui s'emboîtent dans cadres sont Les l'isolation. En les piliers. Elles accueilleront les menuiseries et de la Maison en Pétales. démontables résumé, ce sont les murs e bois, une Il s’agit d’un assemblage collé-cloué de 3 couches d ur de l’habitat. centrale, une vers l’intérieur et une vers l'extérie stil sont en Les découpes des différentes pièces du cadre du pi ficulté soit simple: pas d’angle, juste des coupes à 90°. La dif dit qu' à réside dans la précision des coupes. En charpente on ce n’est pas quelques millimètres près ça ne change pas trop. Ici ectangles le cas. Ce qui va garantir que nos cadres sont bien r n leurs c’est que lors du montage, toutes les pièces ont bie longueurs au millimètre près.

sions Deux mètres rubans peuvent entre eux avoir des dimen tiliser le très légèrement différentes. Une solution c’est d’u même mètre ruban pour toutes les mesures du cadre.

Les cadres ne sont pas encore recouverts de planches d’OSB qui leur donneront leur rigidité. Il est donc conseillé de les contre-venter temporairement avec les lattes de bois, par exemple les futures contre-lattes de la toiture (S-14).

Les cadres extérieurs aux pétales, sont conçus de manière identique aux cadres du pistil. La différence c’est que ce n’est plus les montants verticaux qui sont longs mais les horizontaux. Le “bas” du cadre ne sera donc pas positionné sur le bord court de la table de montage mais sur le bord long. Mis à part cela, les étapes sont les mêmes.

C’est principalement pour l’assemblage des cadres qu’on a eu besoin de fabriquer une Table de montage (voir notice E -Marbres). Comme on va coller les montants ensemble, on peut protéger la table, en posant préalablement du papier sulfurisé

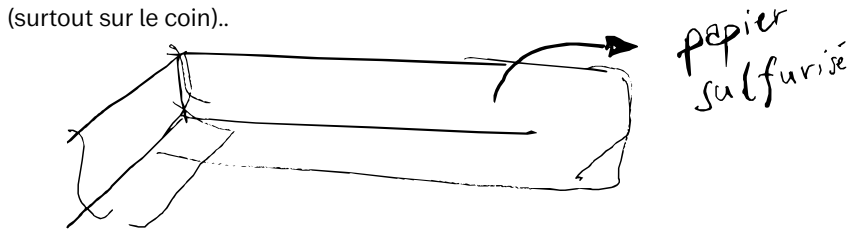
[picture p152: figure]
(surtout sur le coin)..

Les montants sont positionnés de manière particulière. Comme pour les piliers on va s’aider de cales et de serre-joints pour

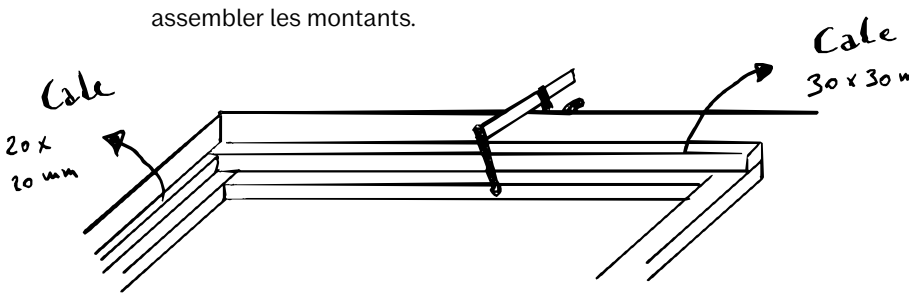
[picture p153: figure]
assembler les montants.
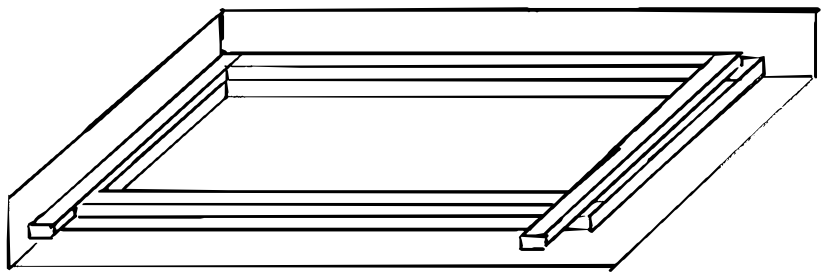
[picture p154: figure]

Comme pour l’assemblage des piliers (voir notice B - Piliers), on va commencer par placer les montants centraux (C1, C2 et C3) et placer dessus les montants extérieurs (C4 et C5) avec la face adéquate enduite de colle PU. Ne pas oublier d'enduire les tranches au niveau des jonctions.

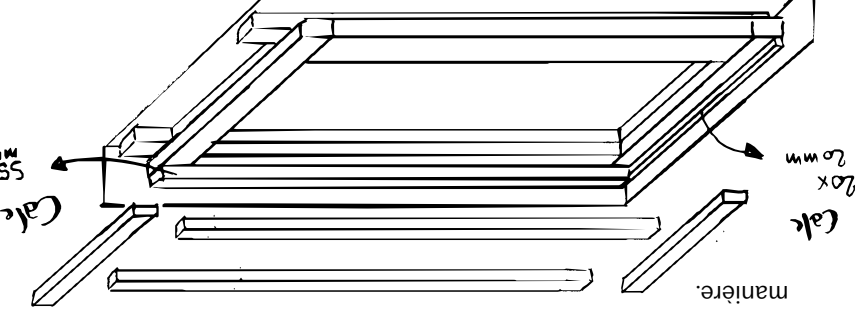
[picture p155: figure]
manière.
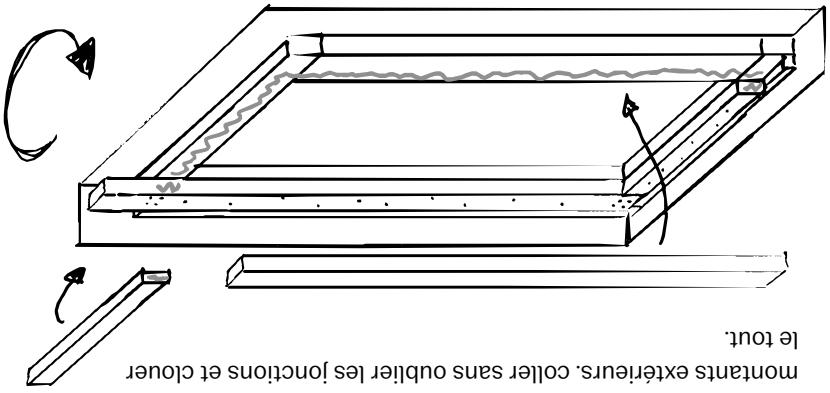
[picture p156: figure]
le tout.
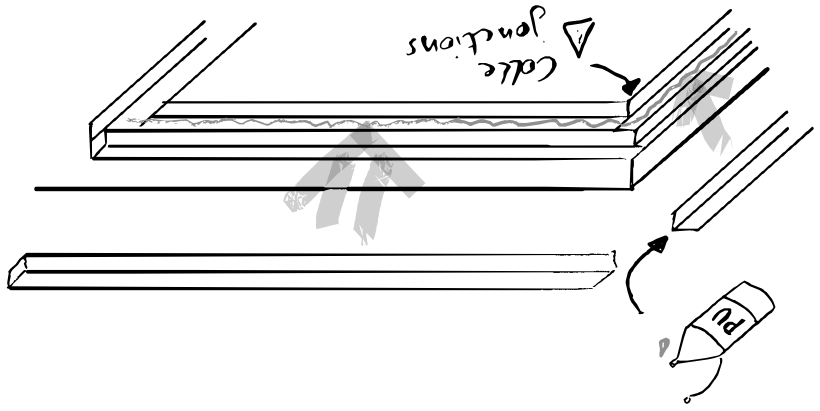
[picture p157: figure]

es On vient ensuite faire la même chose pour les 2 autr ns et clouer montants extérieurs. coller sans oublier les jonctio

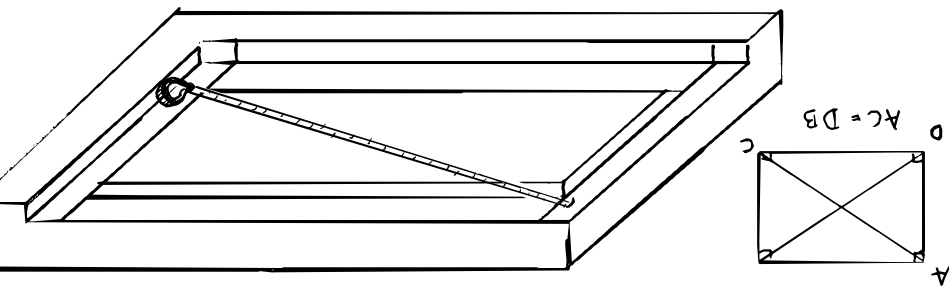
[picture p158: figure]

n retournant le Il ne reste plus qu'à faire l'autre côté. Attention e faire à cadre, il est massif et encore fragile. Mieux vaut le r les plusieurs. On doit ici utiliser un cale de 55 mm pou a même montants verticaux. Et on vient coller et clouer de l

e PU est Même remarque que pour les piliers, la prise de la coll es d’une quinzaine de minutes. Mieux vaut positionner l du cadre montants pour vérifier les mesures et l’orthogonalité e le cadre est avant de mettre la colle. Une manière de vérifier qu re, elles rectangle c’est de mesurer les deux diagonales du cad doivent être identiques (à 2mm près c’est bon).

tants Avant que la colle ne sèche, on vient clouer les mon re 4 clous ensemble avec le cloueur pneumatique. On vient mett angle on dans les coins et ensuite en zigzag et avec un petit les plaquer cloue tous les 20cm environ. Bien penser à

montants ensemble.

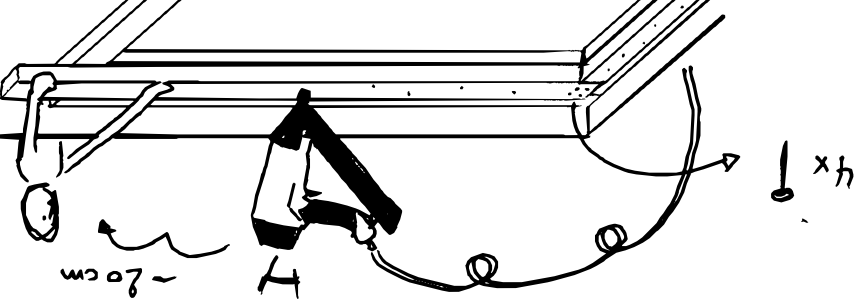
[picture p159: figure]
