mors-es/maison-petales/notices/y_plans_debits.pdf

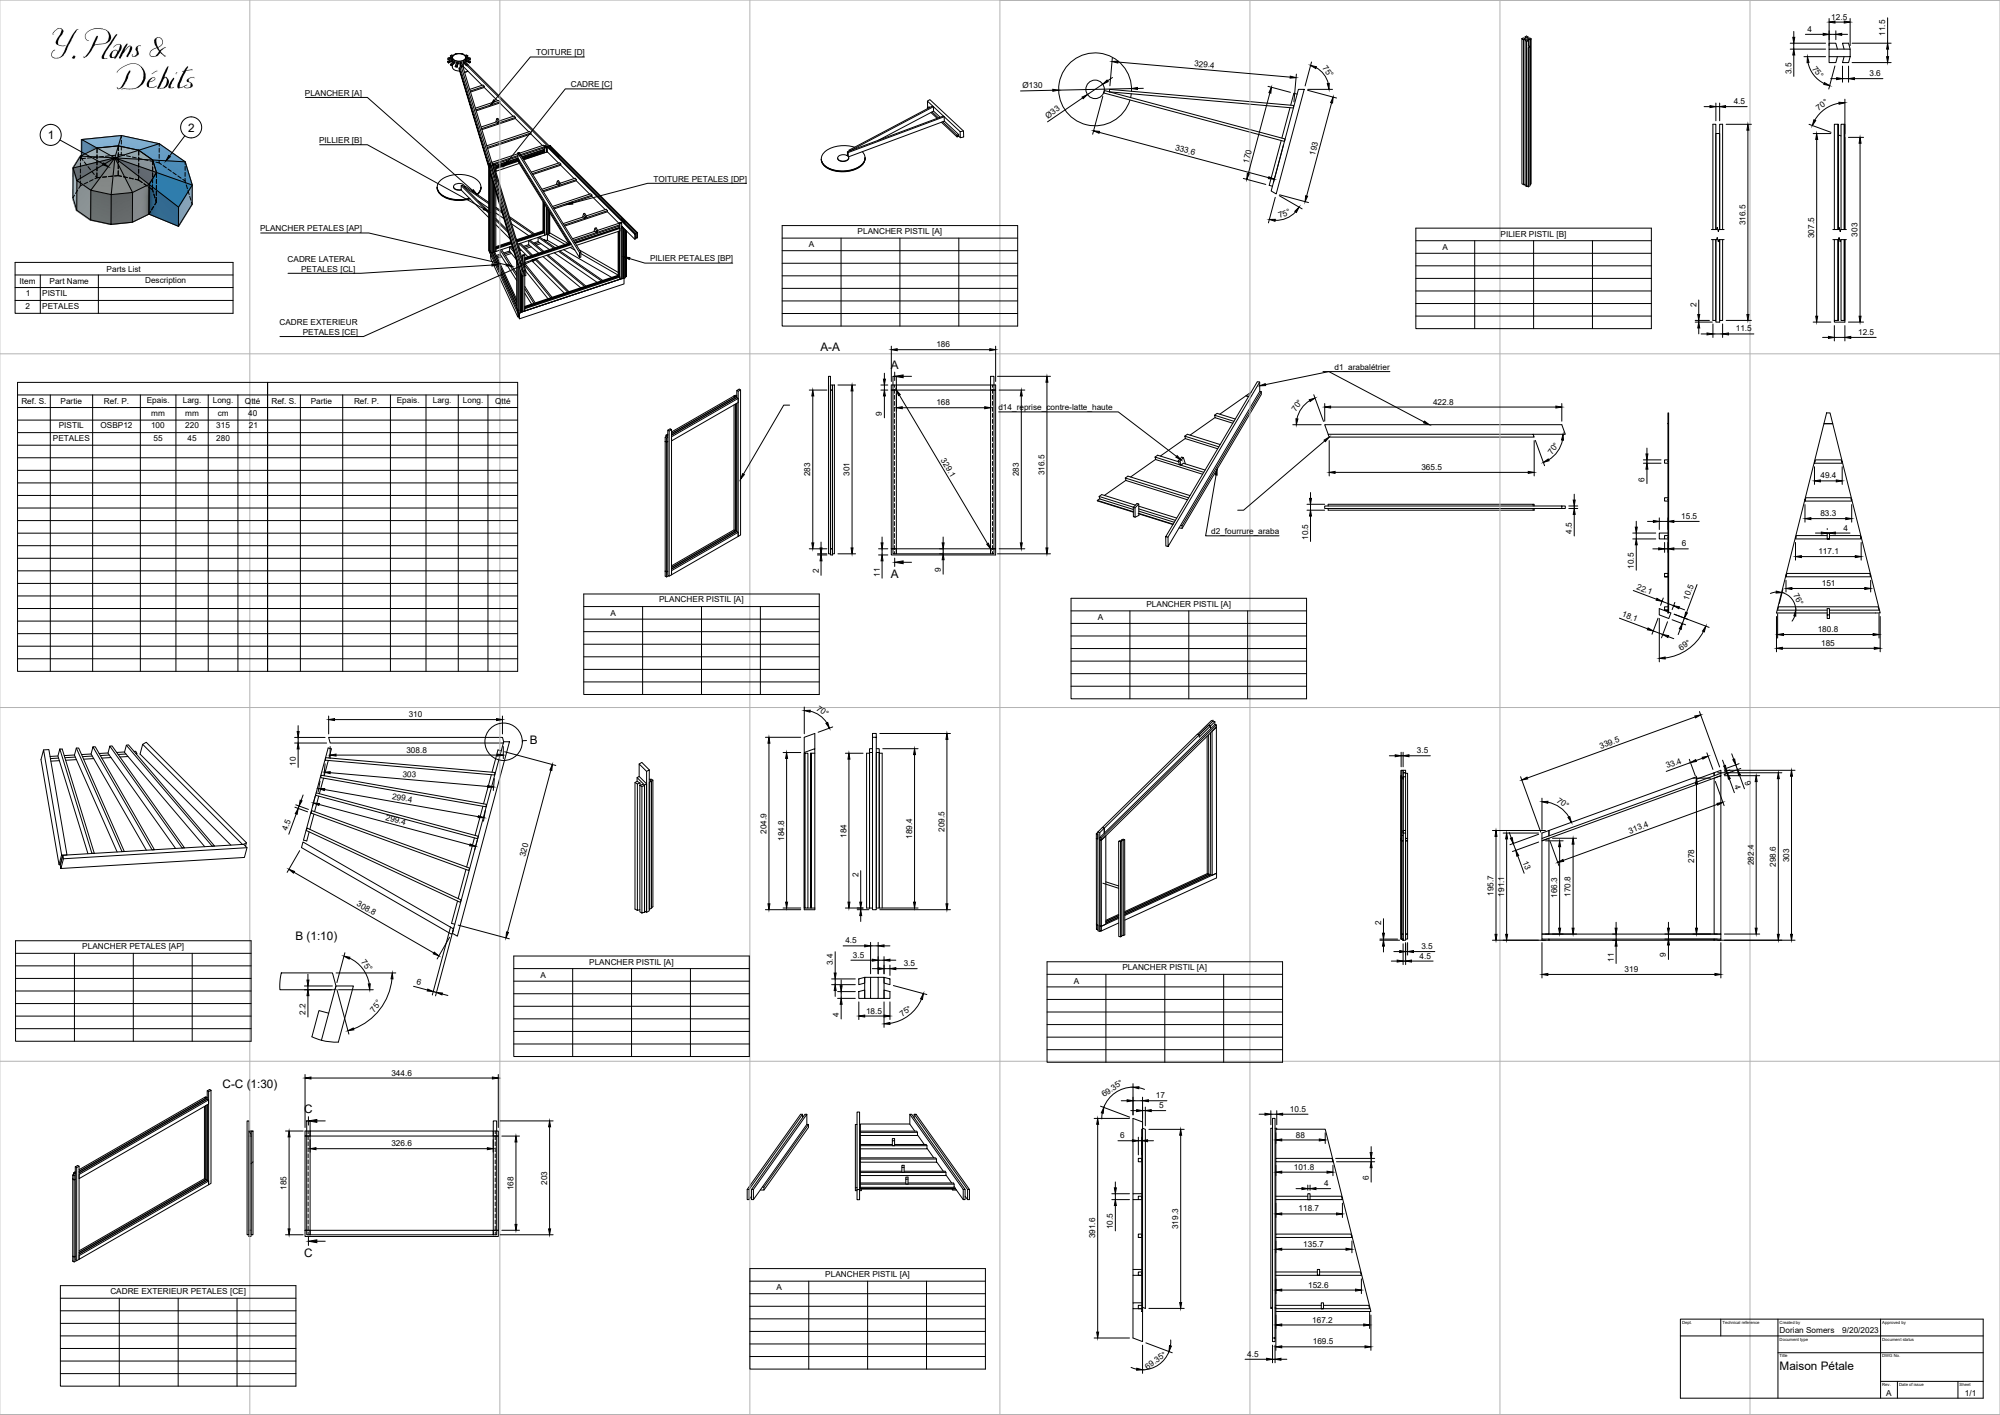
[picture p160: page 1]
Dept.; Technical reference; Created by; Approved by Document type; Document status Title; DWG No. Rev.; Date of issue; Sheet A 9/20/2023; 1/1 Maison Pétale Dorian Somers PLANCHER [A] PILLIER [B]; CADRE [C] TOITURE [D]; 283 2 9 186 168329.1 PLANCHER PISTIL [A] A 83.3 10.5 22.1 18.1 69° 76°; 10.5 15.5 6 6 180.8 185 151 117.1 49.4 70° 70° 4.5 365.5422.8 PLANCHER PISTIL [A] A 299.4 299.4 303 310 B B (1:10)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

3.5 CADRE LATERAL PILIER PETALES [BP] PETALES [CL] CADRE EXTERIEUR PETALES [CE] TOITURE PETALES [DP] PLANCHER PETALES [AP] Ref. S. Partie Ref. P. Epais. Larg. Long. Qtté mm mm cm 40 PISTIL OSBP12 100 220 315 21 PETALES 55 45 280 Ref. S. Partie Ref. P. Epais. Larg. Long. Qtté 2 1 Parts List Item Part Name Description 1 PISTIL 2 PETALES PLANCHER PISTIL [A] A Ø130 Ø33 329.4 333.6 193 170 75° 75° PILIER PISTIL [B] A 70°

119 344.6 CC C-C (1:30) CADRE EXTERIEUR PETALES [CE] 70°339.5 9413 PLANCHER PISTIL [A] A

10 308.8 308.8 320 6 4.5 PLANCHER PETALES [AP] PLANCHER PISTIL [A] A
